teameames/OpenStrain-Bioreactor/README.md

# OpenStrain-Bioreactor
Parts, firmware and assembly details to create an open-source displacement-controlled tensile strain bioreactor for dynamic in vitro cell culture
