teameames/OpenStrain-Bioreactor/OpenStrain Bioreactor Mechanical Unit Solidworks Assembly/Linear Carriage Assembly.SLDASM

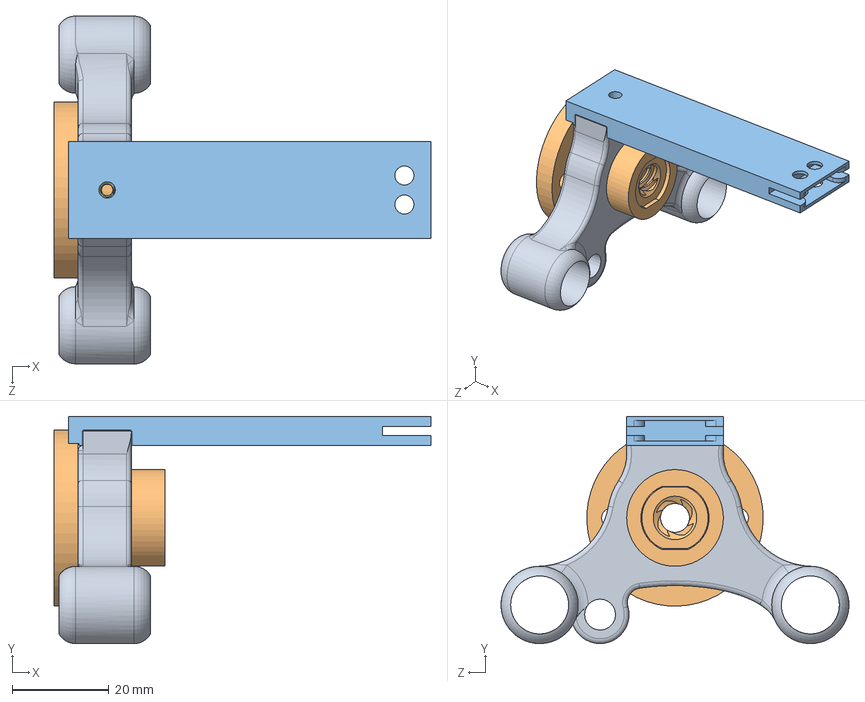
[picture p1: CAD file, 2025-12-15]
OpenStrain Bioreactor Mechanical Unit Solidworks Assembly/Linear Carriage Assembly.SLDASM
78.0 x 47.0 x 72.0 mm
Linear Carriage
Type2 Leadnut
Insert M3 D5 L5mm
