teameames/OpenStrain-Bioreactor/OpenStrain Bioreactor Mechanical Unit Solidworks Assembly/Acrylic well lid assembly.SLDASM

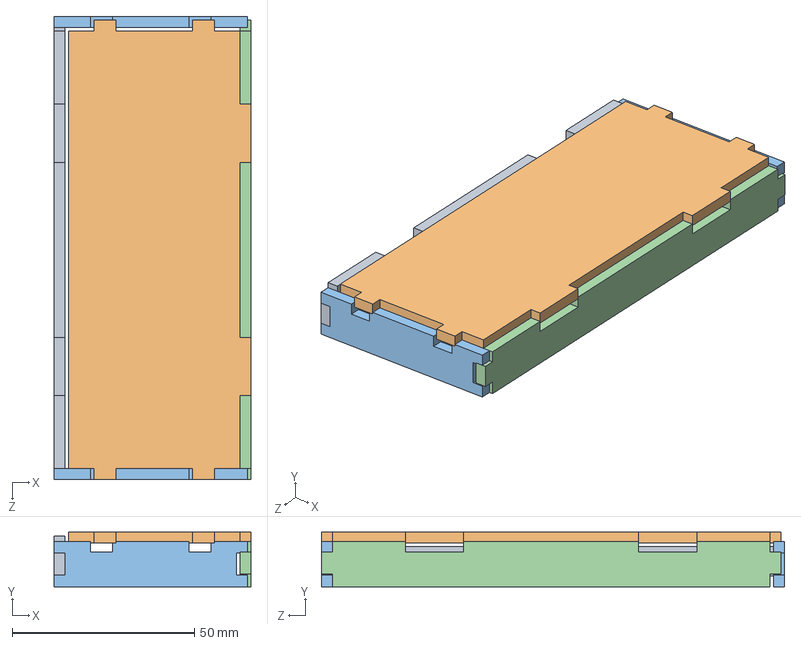
[picture p2: CAD file, 2025-12-15]
OpenStrain Bioreactor Mechanical Unit Solidworks Assembly/Acrylic well lid assembly.SLDASM
54.0 x 15.0 x 127.0 mm
Well Lid Front
Well Lid Side x 2
Well Lid Upper
Well Lid Rear
