teameames/OpenStrain-Bioreactor/OpenStrain Bioreactor Control Unit Solidworks Assembly/Board base.SLDPRT

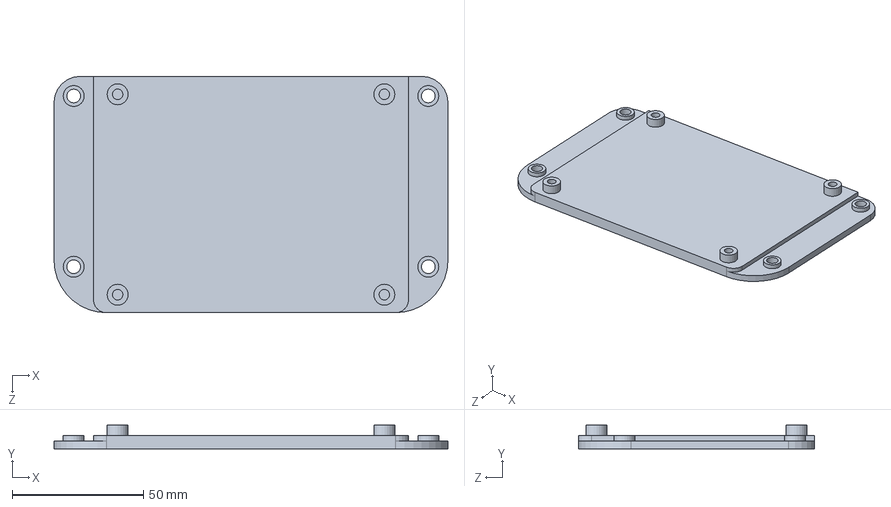
[picture p3: CAD file, 2025-12-15]
OpenStrain Bioreactor Control Unit Solidworks Assembly/Board base.SLDPRT
150.0 x 9.00 x 90.0 mm
