teameames/OpenStrain-Bioreactor/OpenStrain Bioreactor Control Unit STEP files/Adafruit 5.5 x 2.1 DC Coax Panel Mount Power Jack (PN 601)_default.STEP

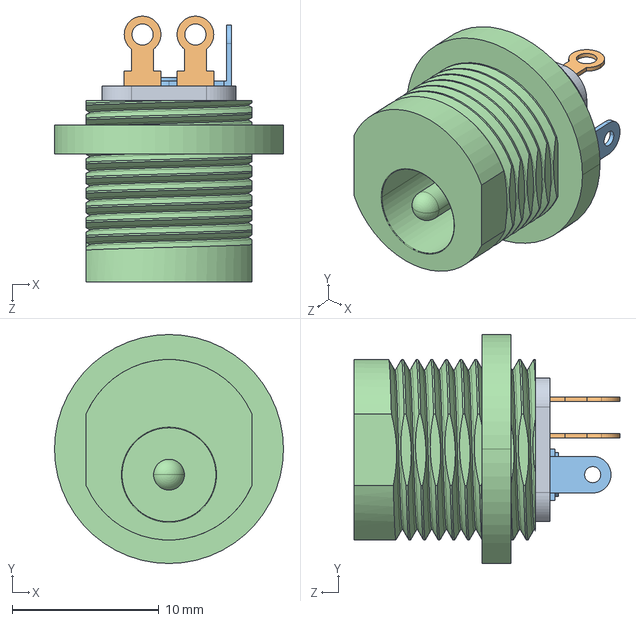
[picture p4: CAD file, 2025-12-15]
OpenStrain Bioreactor Control Unit STEP files/Adafruit 5.5 x 2.1 DC Coax Panel Mount Power Jack (PN 601)_default.STEP
15.6 x 15.6 x 18.1 mm
