teameames/OpenStrain-Bioreactor/OpenStrain Bioreactor Mechanical Unit Solidworks Assembly/Drive Box Base.SLDPRT

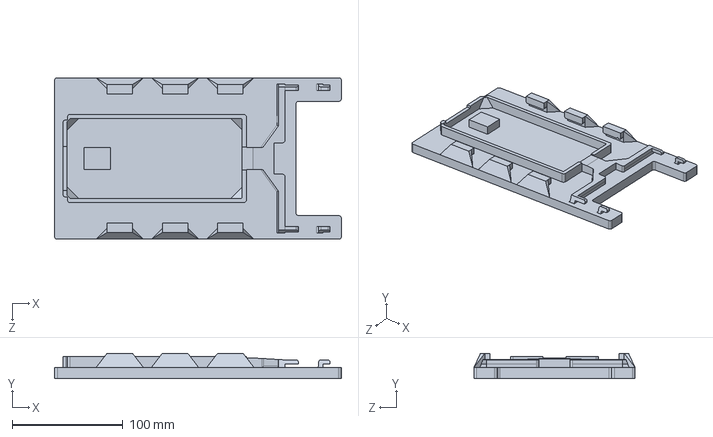
[picture p5: CAD file, 2025-12-15]
OpenStrain Bioreactor Mechanical Unit Solidworks Assembly/Drive Box Base.SLDPRT
259.5 x 23.0 x 146.0 mm
