teameames/OpenStrain-Bioreactor/OpenStrain Bioreactor Control Unit Solidworks Assembly/Case Face.SLDPRT

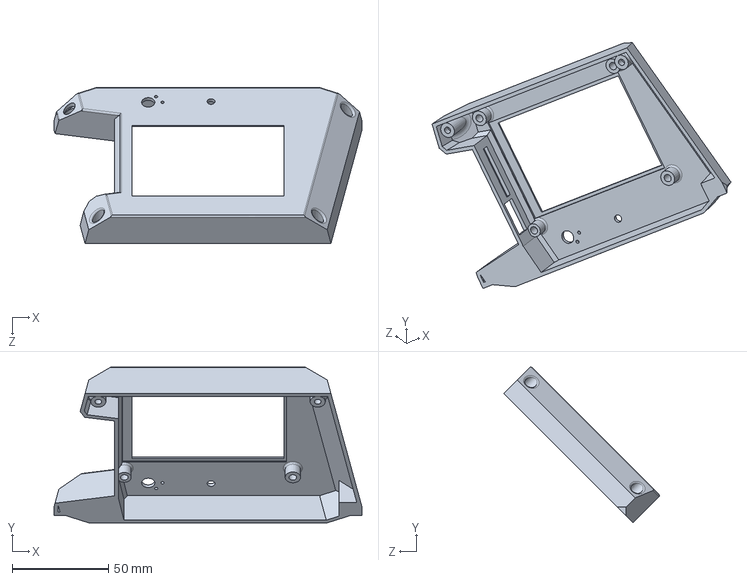
[picture p6: CAD file, 2025-12-15]
OpenStrain Bioreactor Control Unit Solidworks Assembly/Case Face.SLDPRT
160.0 x 80.9 x 80.9 mm
