teameames/OpenStrain-Bioreactor/OpenStrain Bioreactor Control Unit STEP files/30X30X10 DC fan.STEP

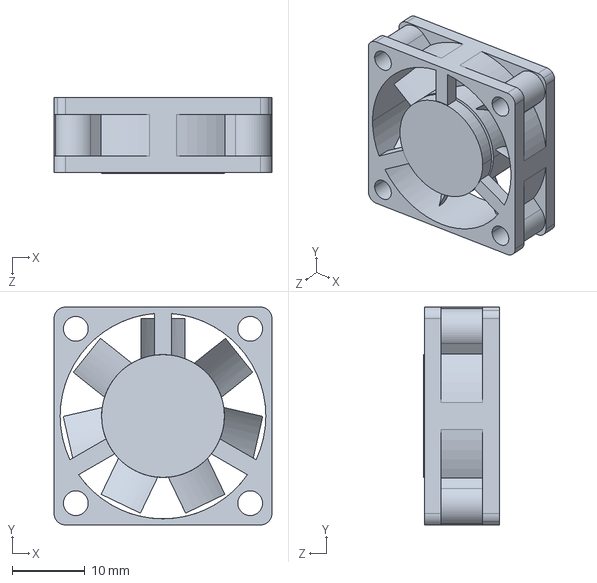
[picture p7: CAD file, 2025-12-15]
OpenStrain Bioreactor Control Unit STEP files/30X30X10 DC fan.STEP
30.0 x 30.0 x 10.4 mm
