teameames/OpenStrain-Bioreactor/OpenStrain Bioreactor Mechanical Unit Solidworks Assembly/Insert M3 D5 L5mm.stp

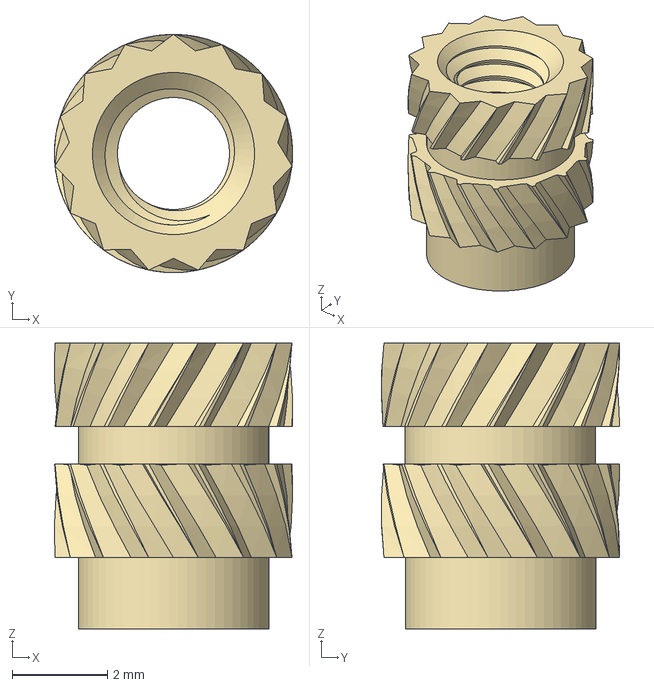
[picture p8: CAD file, 2025-12-15]
OpenStrain Bioreactor Mechanical Unit Solidworks Assembly/Insert M3 D5 L5mm.stp
5.00 x 5.00 x 6.00 mm
