teameames/OpenStrain-Bioreactor/OpenStrain Bioreactor Control Unit Solidworks Assembly/Case Master V2.SLDPRT

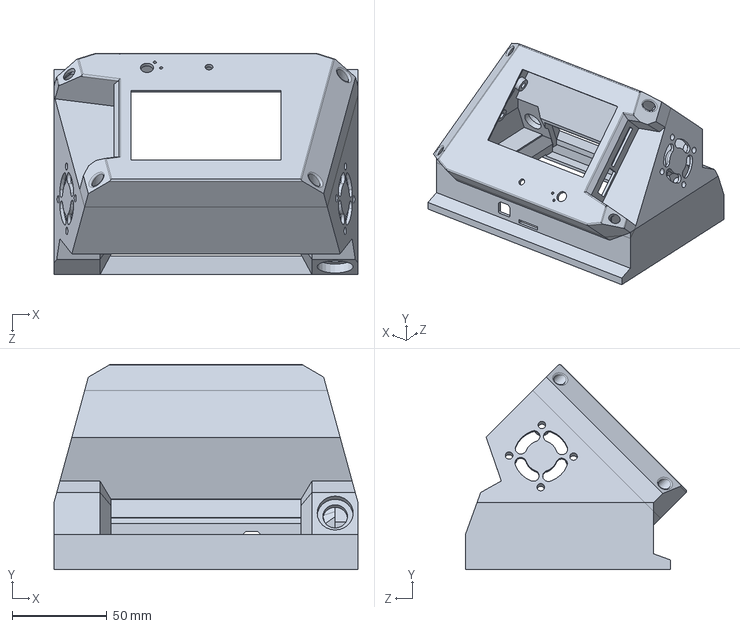
[picture p9: CAD file, 2025-12-15]
OpenStrain Bioreactor Control Unit Solidworks Assembly/Case Master V2.SLDPRT
160.0 x 107.9 x 116.4 mm
