teameames/OpenStrain-Bioreactor/OpenStrain Bioreactor Control Unit STEP files/Insert M5 D7 L9.5mm.STEP

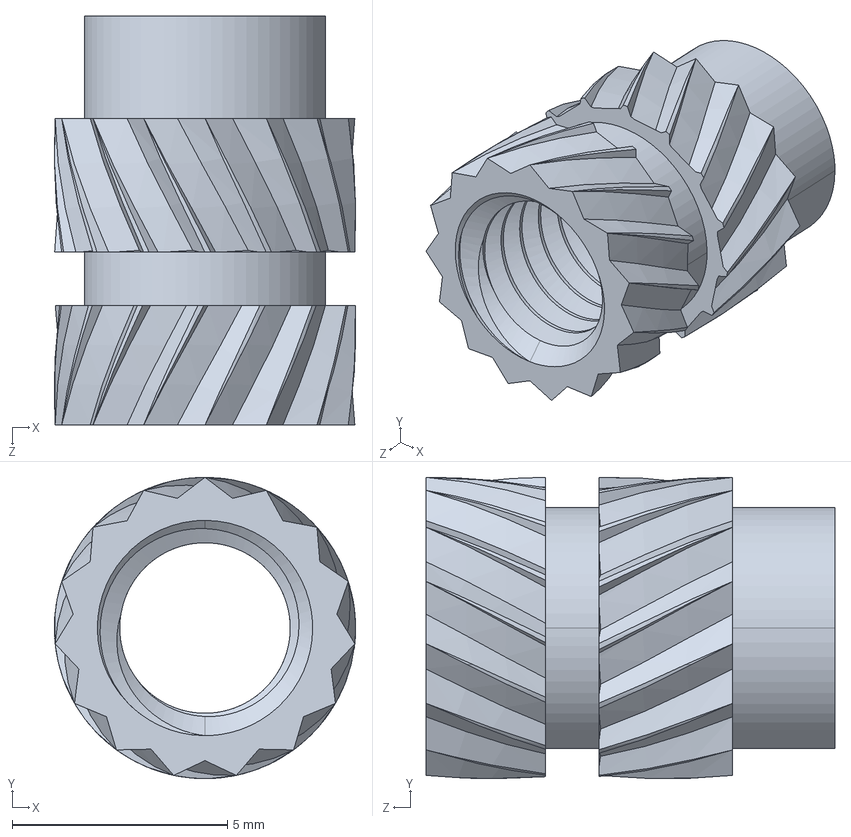
[picture p10: CAD file, 2025-12-15]
OpenStrain Bioreactor Control Unit STEP files/Insert M5 D7 L9.5mm.STEP
7.00 x 7.00 x 9.50 mm
