teameames/OpenStrain-Bioreactor/OpenStrain Bioreactor Mechanical Unit Solidworks Assembly/Well Lid Upper.SLDPRT

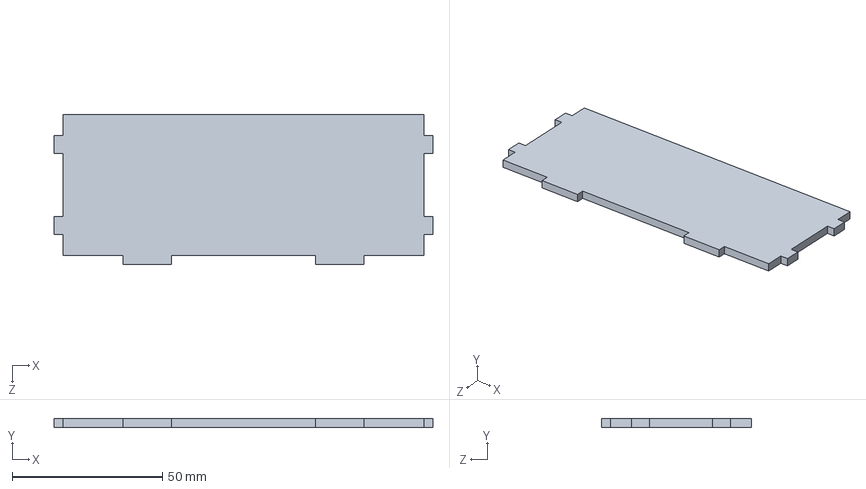
[picture p11: CAD file, 2025-12-15]
OpenStrain Bioreactor Mechanical Unit Solidworks Assembly/Well Lid Upper.SLDPRT
126.0 x 3.00 x 50.0 mm
