teameames/OpenStrain-Bioreactor/OpenStrain Bioreactor Mechanical Unit STEP files/Motor screen window.STEP

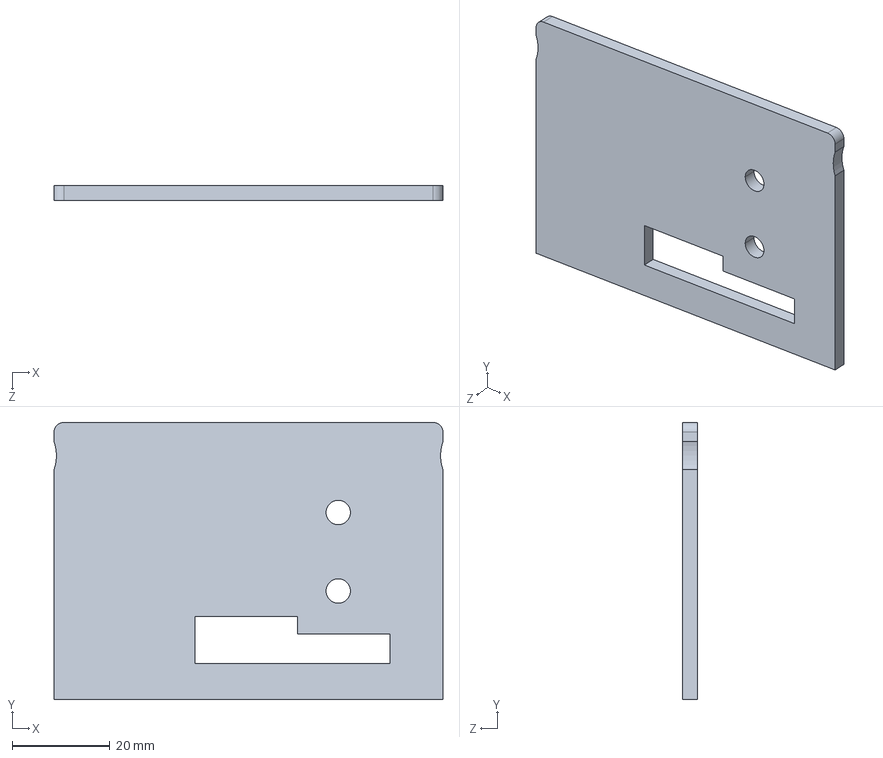
[picture p12: CAD file, 2025-12-15]
OpenStrain Bioreactor Mechanical Unit STEP files/Motor screen window.STEP
79.8 x 56.8 x 3.00 mm
