teameames/OpenStrain-Bioreactor/OpenStrain Bioreactor Control Unit STEP files/Case Face V3.STEP

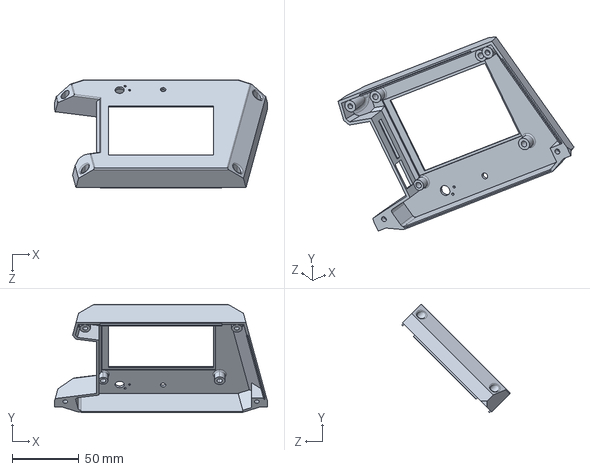
[picture p13: CAD file, 2025-12-15]
OpenStrain Bioreactor Control Unit STEP files/Case Face V3.STEP
160.0 x 81.2 x 81.2 mm
