teameames/OpenStrain-Bioreactor/OpenStrain Bioreactor Mechanical Unit STEP files/8mm Arm Key.STEP

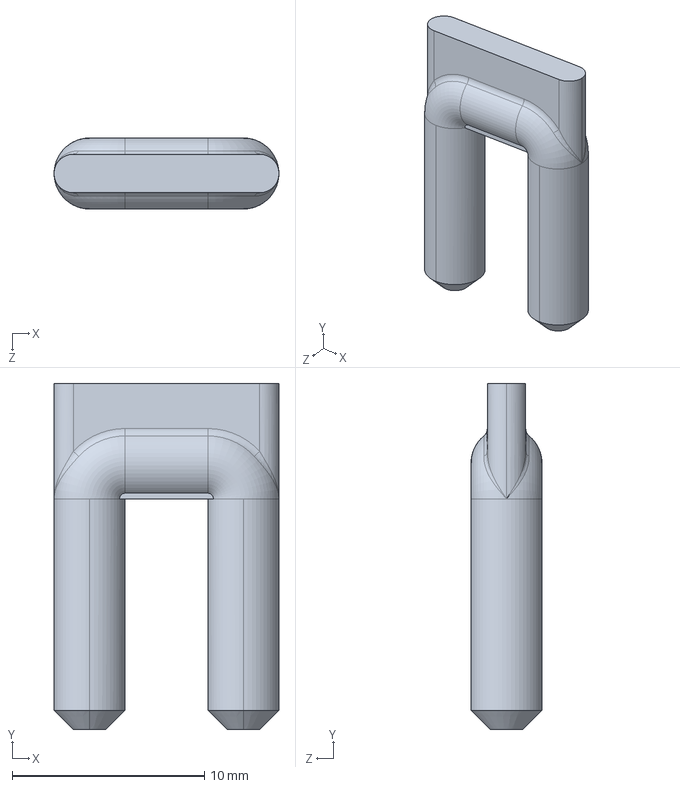
[picture p14: CAD file, 2025-12-15]
OpenStrain Bioreactor Mechanical Unit STEP files/8mm Arm Key.STEP
11.7 x 18.0 x 3.70 mm
