teameames/OpenStrain-Bioreactor/OpenStrain Bioreactor Control Unit Solidworks Assembly/Case Base.SLDPRT

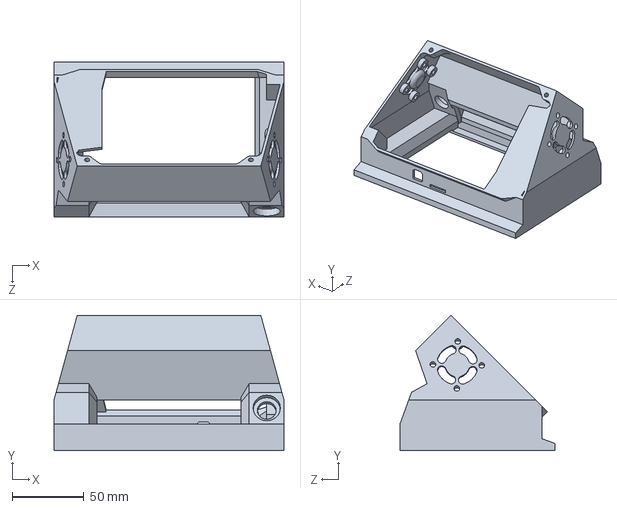
[picture p15: CAD file, 2025-12-15]
OpenStrain Bioreactor Control Unit Solidworks Assembly/Case Base.SLDPRT
160.0 x 94.2 x 108.0 mm
