teameames/OpenStrain-Bioreactor/OpenStrain Bioreactor Mechanical Unit Solidworks Assembly/8mm M5 spring.SLDPRT

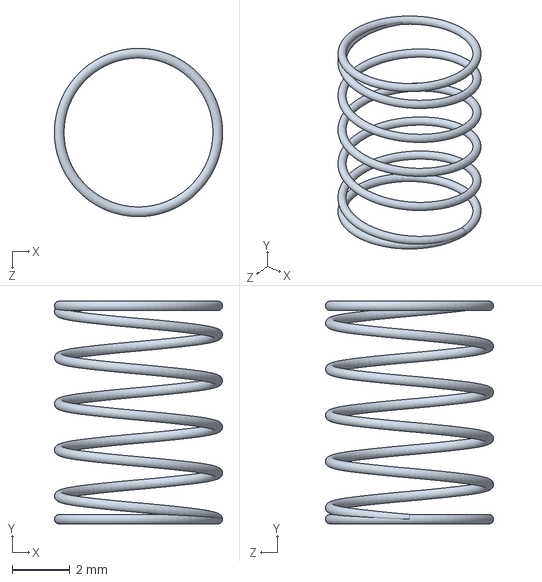
[picture p16: CAD file, 2025-12-15]
OpenStrain Bioreactor Mechanical Unit Solidworks Assembly/8mm M5 spring.SLDPRT
5.84 x 7.74 x 5.84 mm
