teameames/OpenStrain-Bioreactor/OpenStrain Bioreactor Mechanical Unit STEP files/Rack A_Metric - Rack-spur - rectangular 2M 20PA 10FW 10PH 150L---SAll.STEP

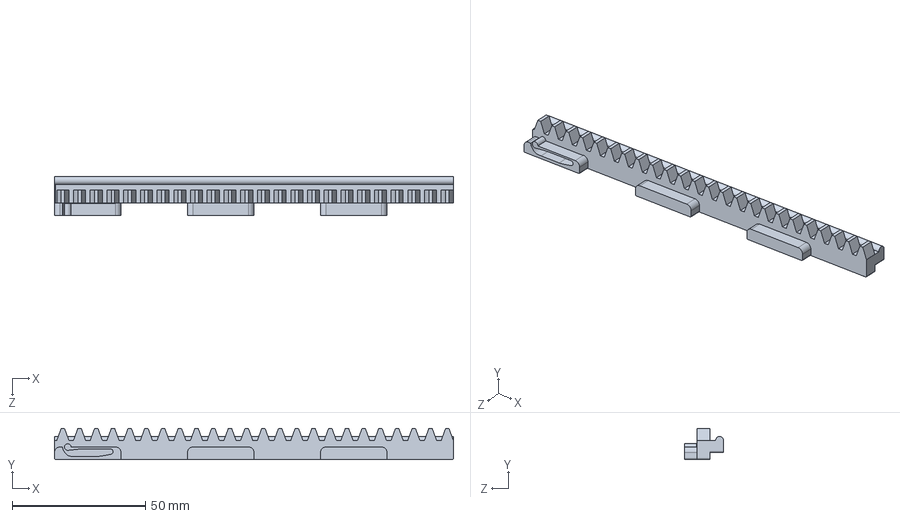
[picture p17: CAD file, 2025-12-15]
OpenStrain Bioreactor Mechanical Unit STEP files/Rack A_Metric - Rack-spur - rectangular 2M 20PA 10FW 10PH 150L---SAll.STEP
150.0 x 11.7 x 14.8 mm
