teameames/OpenStrain-Bioreactor/OpenStrain Bioreactor Mechanical Unit Solidworks Assembly/Well Lid Rear.SLDPRT

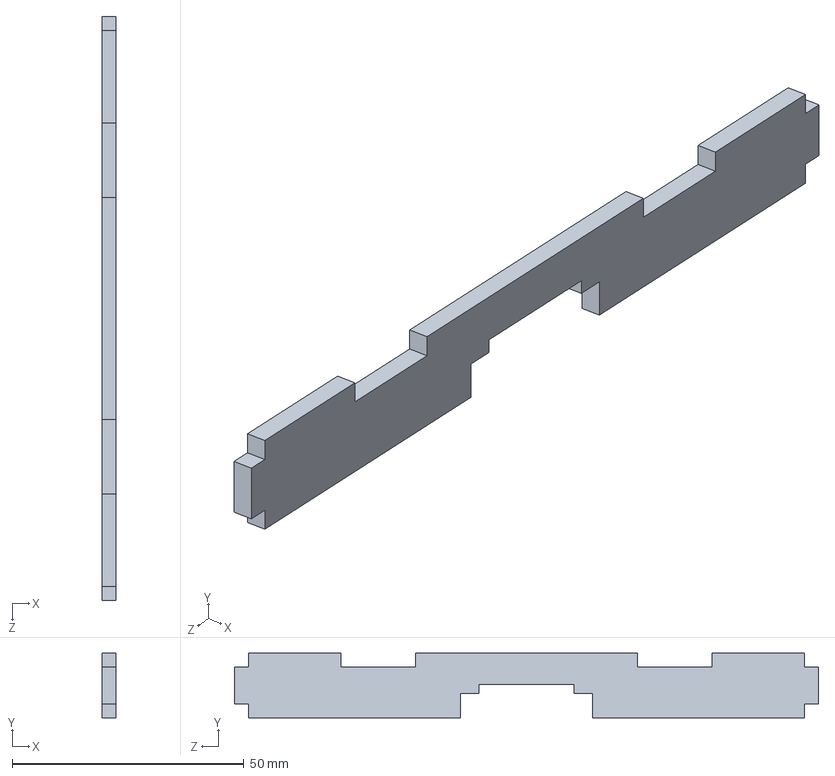
[picture p18: CAD file, 2025-12-15]
OpenStrain Bioreactor Mechanical Unit Solidworks Assembly/Well Lid Rear.SLDPRT
3.00 x 14.0 x 126.0 mm
