teameames/OpenStrain-Bioreactor/OpenStrain Bioreactor Mechanical Unit STEP files/Well Clamp.STEP

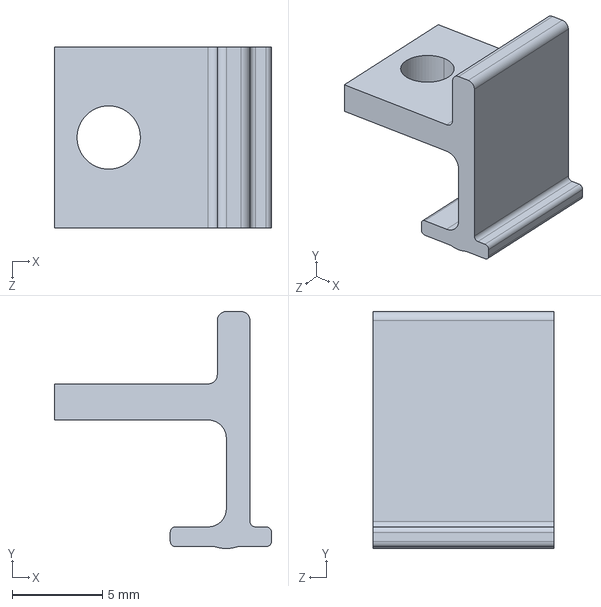
[picture p19: CAD file, 2025-12-15]
OpenStrain Bioreactor Mechanical Unit STEP files/Well Clamp.STEP
12.0 x 13.1 x 10.0 mm
