teameames/OpenStrain-Bioreactor/OpenStrain Bioreactor Control Unit STEP files/Case Base V3.STEP

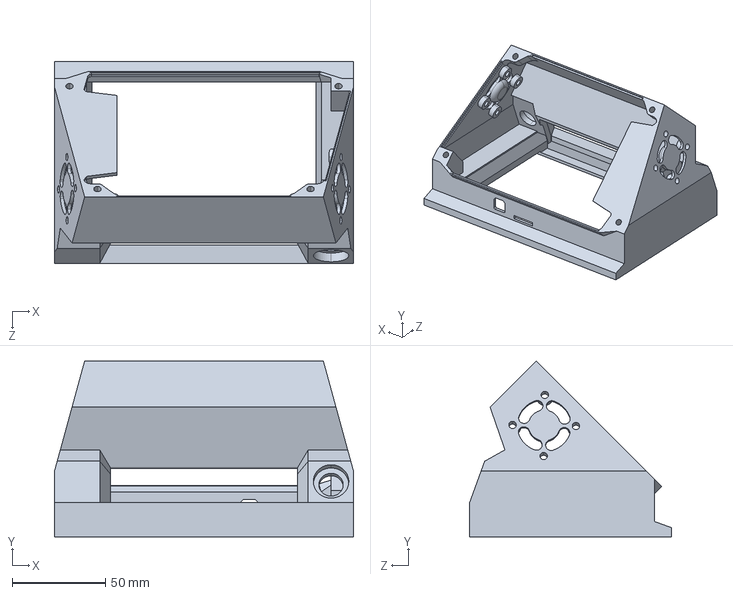
[picture p20: CAD file, 2025-12-15]
OpenStrain Bioreactor Control Unit STEP files/Case Base V3.STEP
160.0 x 94.2 x 108.0 mm
