teameames/OpenStrain-Bioreactor/OpenStrain Bioreactor Mechanical Unit STEP files/Well Lid Side.STEP

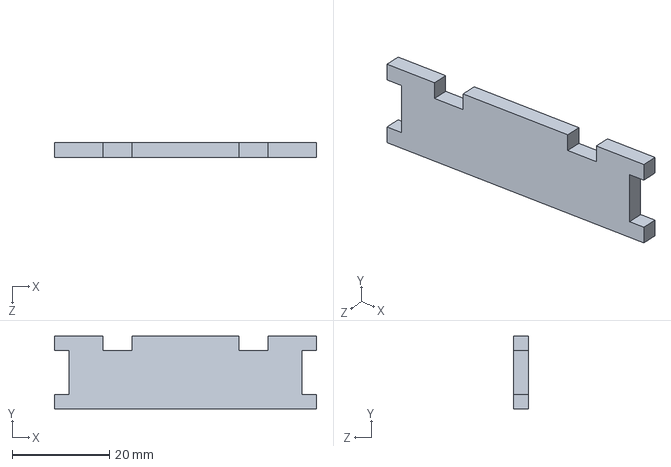
[picture p21: CAD file, 2025-12-15]
OpenStrain Bioreactor Mechanical Unit STEP files/Well Lid Side.STEP
54.0 x 15.0 x 3.00 mm
