teameames/OpenStrain-Bioreactor/OpenStrain Bioreactor Mechanical Unit STEP files/Motor base.STEP

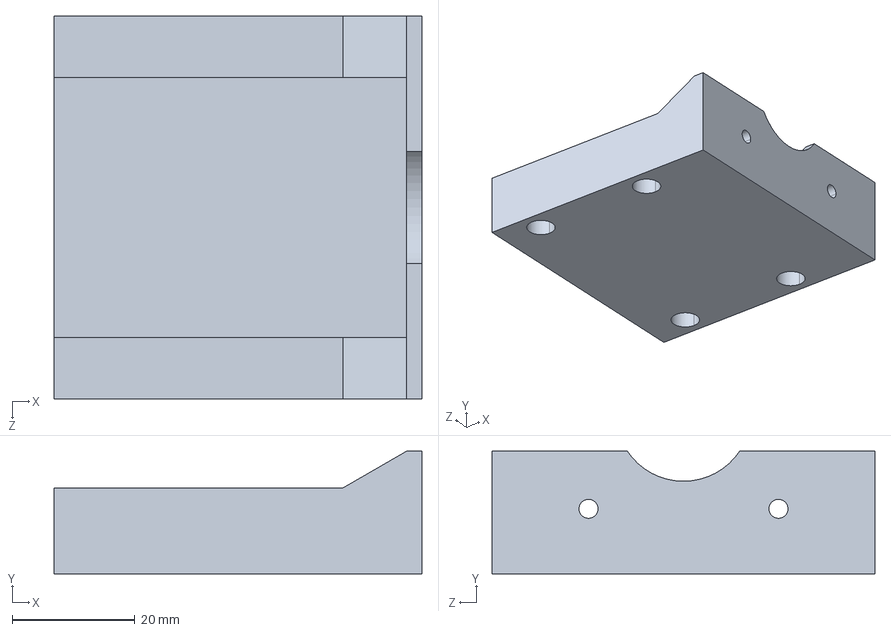
[picture p22: CAD file, 2025-12-15]
OpenStrain Bioreactor Mechanical Unit STEP files/Motor base.STEP
60.0 x 20.0 x 62.5 mm
