teameames/OpenStrain-Bioreactor/OpenStrain Bioreactor Mechanical Unit Solidworks Assembly/Arm Clamp.SLDPRT

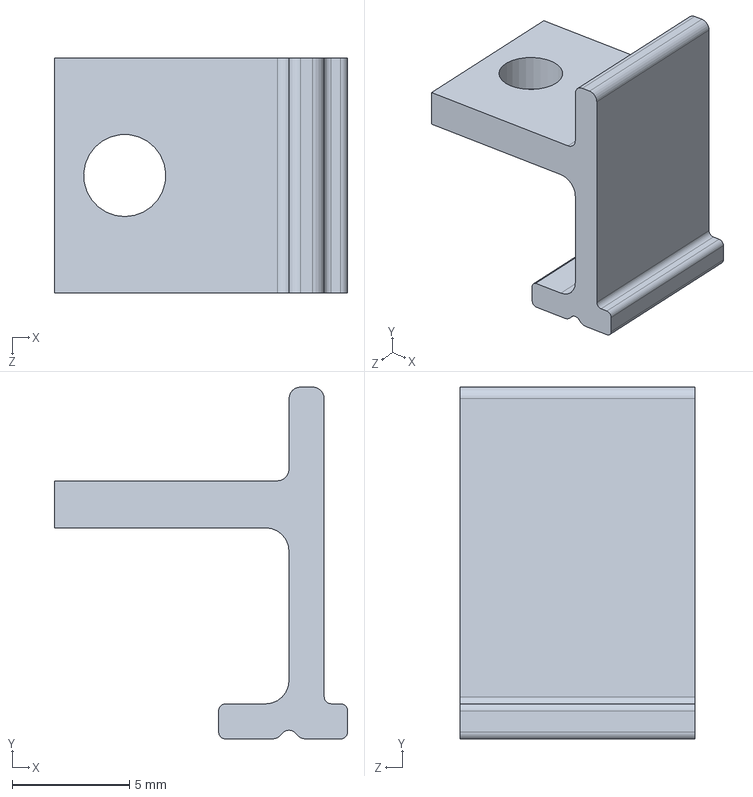
[picture p23: CAD file, 2025-12-15]
OpenStrain Bioreactor Mechanical Unit Solidworks Assembly/Arm Clamp.SLDPRT
12.5 x 15.0 x 10.0 mm
