teameames/OpenStrain-Bioreactor/OpenStrain Bioreactor Mechanical Unit STEP files/Arm Clamp.STEP

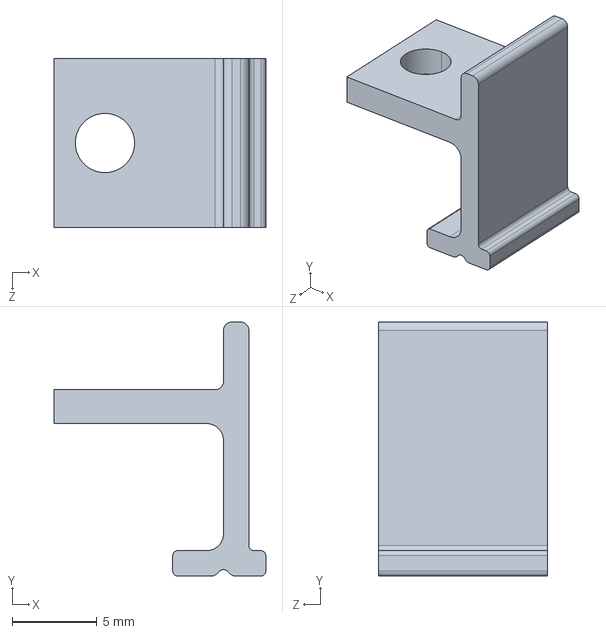
[picture p24: CAD file, 2025-12-15]
OpenStrain Bioreactor Mechanical Unit STEP files/Arm Clamp.STEP
12.5 x 15.0 x 10.0 mm
