teameames/OpenStrain-Bioreactor/OpenStrain Bioreactor Mechanical Unit Solidworks Assembly/G10 Type2 Pull Arm.SLDPRT

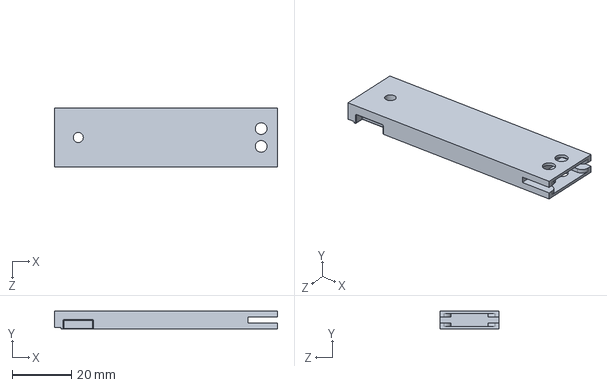
[picture p25: CAD file, 2025-12-15]
OpenStrain Bioreactor Mechanical Unit Solidworks Assembly/G10 Type2 Pull Arm.SLDPRT
75.0 x 6.00 x 20.0 mm
