teameames/OpenStrain-Bioreactor/OpenStrain Bioreactor Mechanical Unit STEP files/Well Lid Front.STEP

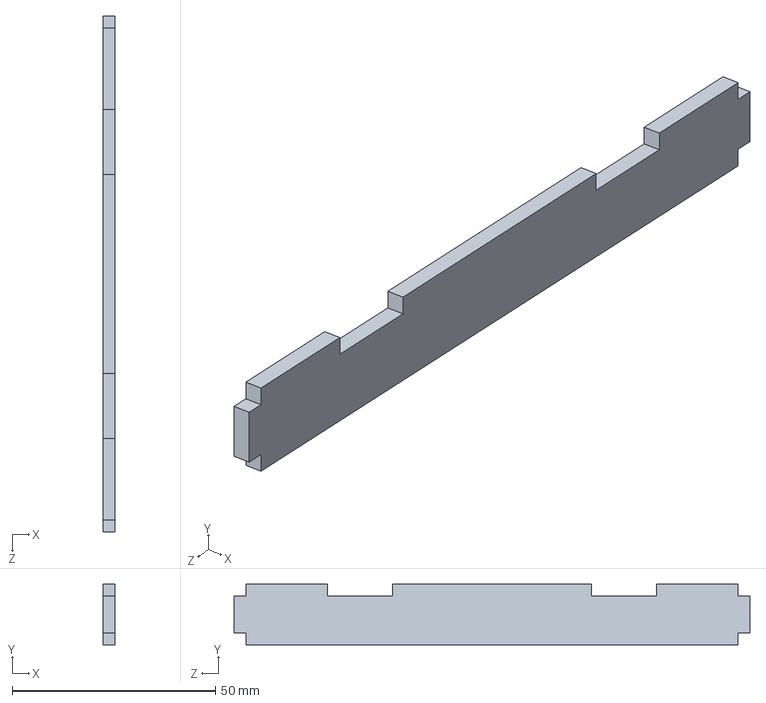
[picture p26: CAD file, 2025-12-15]
OpenStrain Bioreactor Mechanical Unit STEP files/Well Lid Front.STEP
3.00 x 15.0 x 127.0 mm
