teameames/OpenStrain-Bioreactor/OpenStrain Bioreactor Mechanical Unit Solidworks Assembly/Smooth Shaft Clasp A.SLDPRT

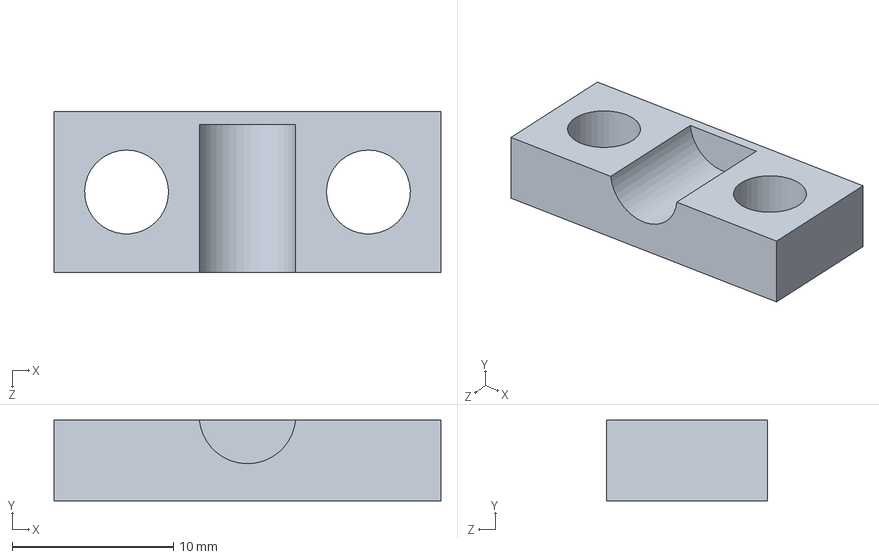
[picture p27: CAD file, 2025-12-15]
OpenStrain Bioreactor Mechanical Unit Solidworks Assembly/Smooth Shaft Clasp A.SLDPRT
24.0 x 5.00 x 10.0 mm
