teameames/OpenStrain-Bioreactor/OpenStrain Bioreactor Mechanical Unit STEP files/MirrorGen10 Smooth Single Clasp.STEP

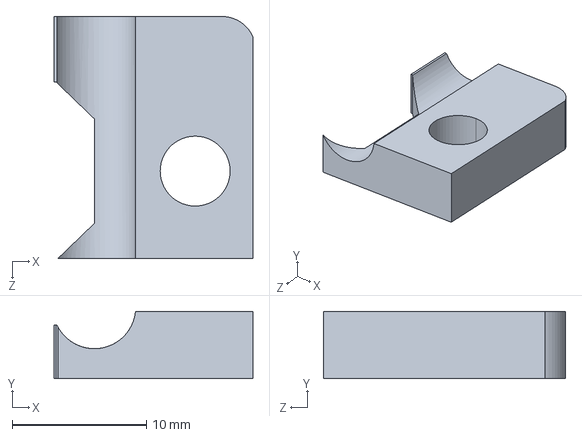
[picture p28: CAD file, 2025-12-15]
OpenStrain Bioreactor Mechanical Unit STEP files/MirrorGen10 Smooth Single Clasp.STEP
14.8 x 5.00 x 18.0 mm
