teameames/OpenStrain-Bioreactor/OpenStrain Bioreactor Mechanical Unit STEP files/spur gear_Metric - Spur gear 2M 16T 20PA 5FW ---S16N75H50L5N.STEP

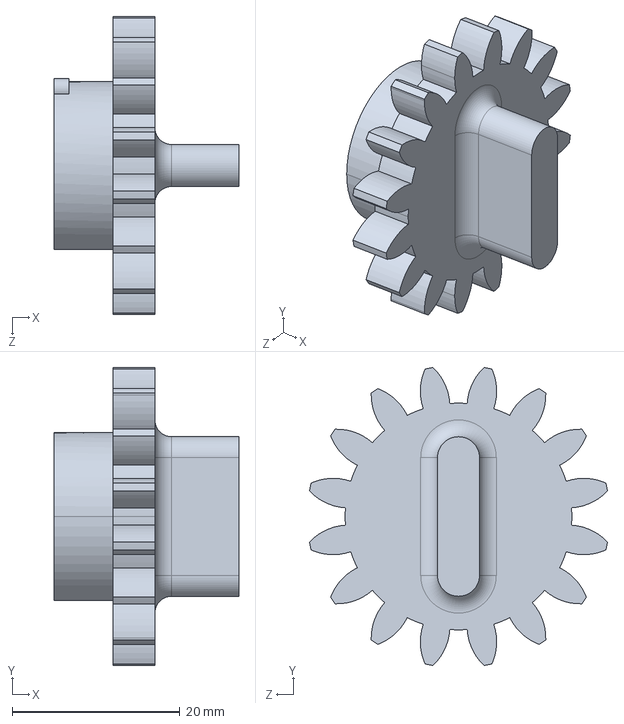
[picture p29: CAD file, 2025-12-15]
OpenStrain Bioreactor Mechanical Unit STEP files/spur gear_Metric - Spur gear 2M 16T 20PA 5FW ---S16N75H50L5N.STEP
22.0 x 35.5 x 35.5 mm
