teameames/OpenStrain-Bioreactor/OpenStrain Bioreactor Mechanical Unit Solidworks Assembly/Shaft coupling.SLDPRT

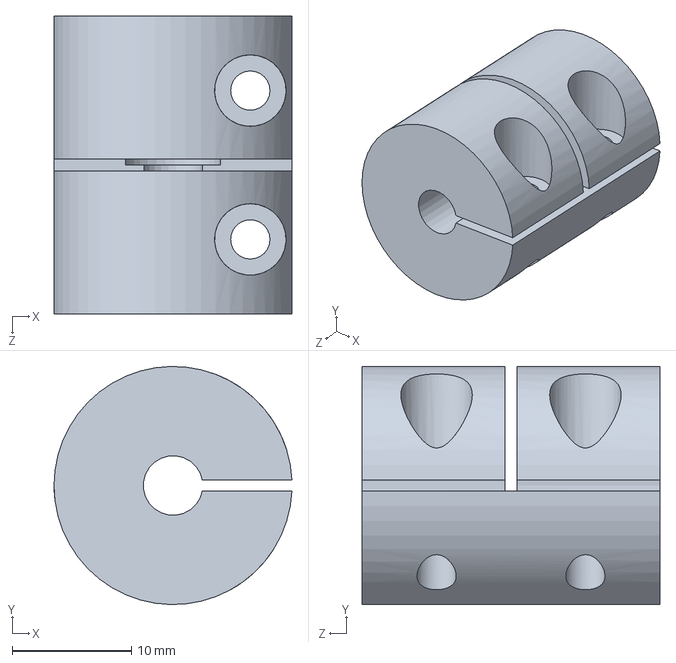
[picture p30: CAD file, 2025-12-15]
OpenStrain Bioreactor Mechanical Unit Solidworks Assembly/Shaft coupling.SLDPRT
20.0 x 20.0 x 25.0 mm
