teameames/OpenStrain-Bioreactor/OpenStrain Bioreactor Mechanical Unit Solidworks Assembly/Well Lid Front.SLDPRT

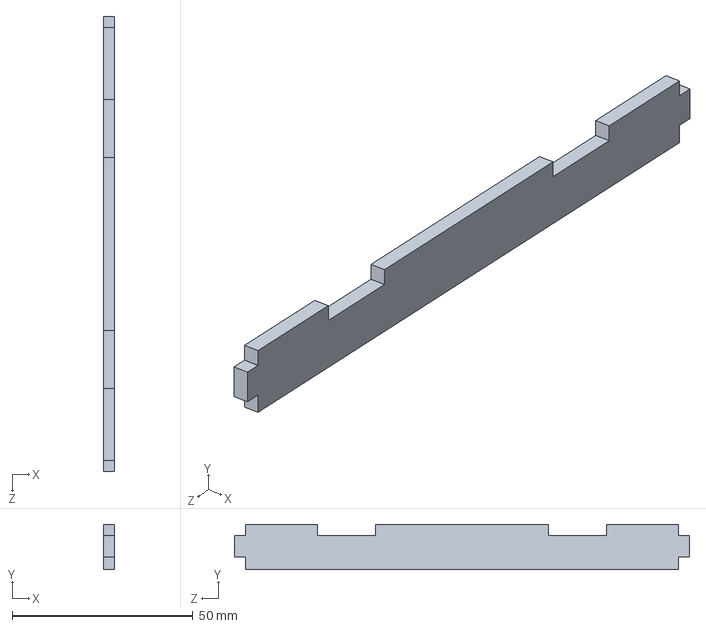
[picture p31: CAD file, 2025-12-15]
OpenStrain Bioreactor Mechanical Unit Solidworks Assembly/Well Lid Front.SLDPRT
3.00 x 12.5 x 126.0 mm
