teameames/OpenStrain-Bioreactor/OpenStrain Bioreactor Mechanical Unit STEP files/Well Lid Upper.STEP

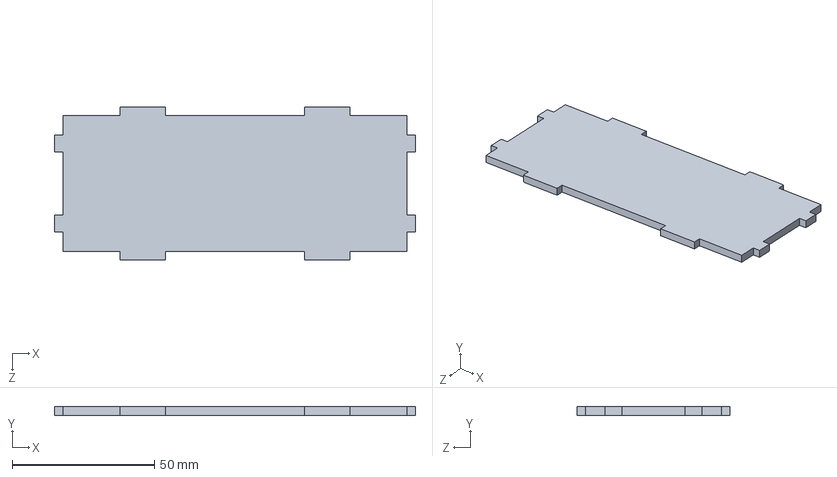
[picture p32: CAD file, 2025-12-15]
OpenStrain Bioreactor Mechanical Unit STEP files/Well Lid Upper.STEP
127.0 x 3.00 x 54.0 mm
