teameames/OpenStrain-Bioreactor/OpenStrain Bioreactor Mechanical Unit Solidworks Assembly/Drive Box.SLDPRT

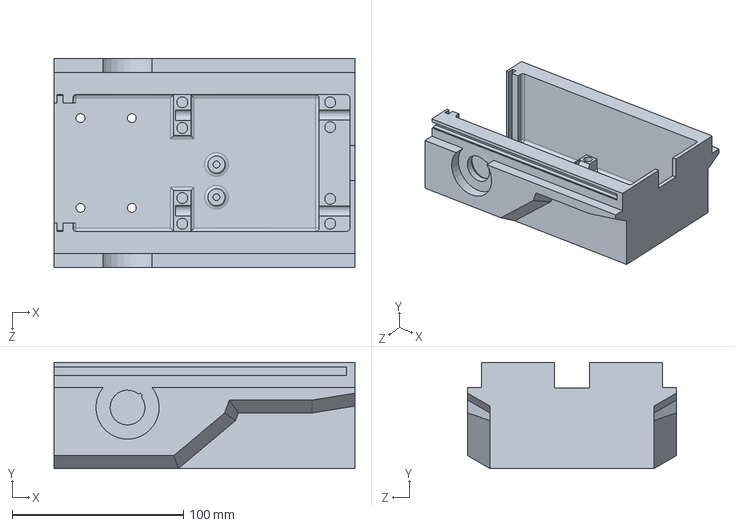
[picture p33: CAD file, 2025-12-15]
OpenStrain Bioreactor Mechanical Unit Solidworks Assembly/Drive Box.SLDPRT
176.0 x 62.0 x 122.0 mm
