teameames/OpenStrain-Bioreactor/OpenStrain Bioreactor Mechanical Unit Solidworks Assembly/Steel Pull Rake.SLDPRT

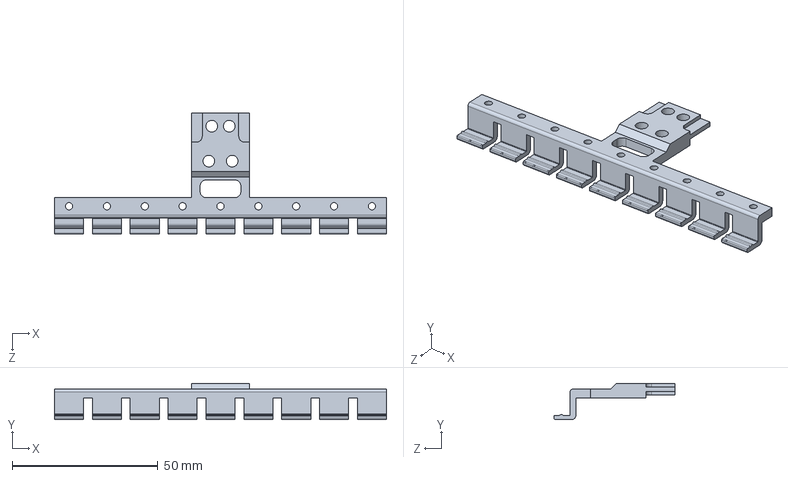
[picture p34: CAD file, 2025-12-15]
OpenStrain Bioreactor Mechanical Unit Solidworks Assembly/Steel Pull Rake.SLDPRT
114.0 x 12.5 x 41.5 mm
