teameames/OpenStrain-Bioreactor/OpenStrain Bioreactor Mechanical Unit Solidworks Assembly/Limit_switch.SLDPRT

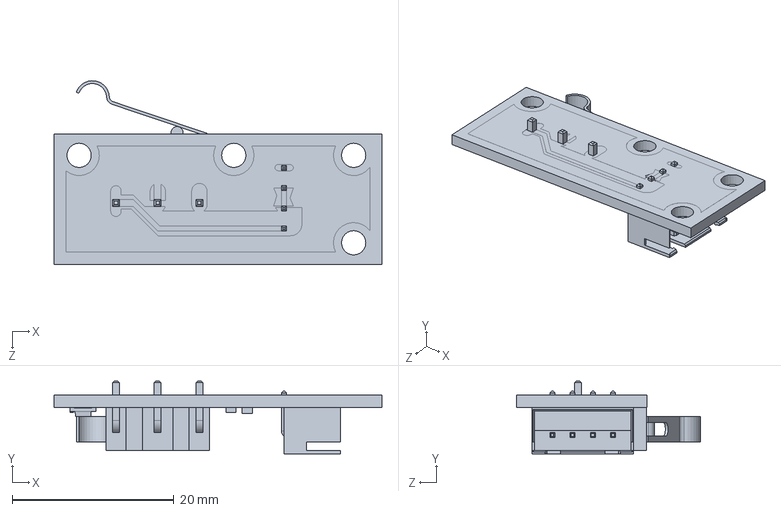
[picture p35: CAD file, 2025-12-15]
OpenStrain Bioreactor Mechanical Unit Solidworks Assembly/Limit_switch.SLDPRT
40.5 x 9.00 x 22.7 mm
