teameames/OpenStrain-Bioreactor/OpenStrain Bioreactor Mechanical Unit Solidworks Assembly/Well Lid Side.SLDPRT

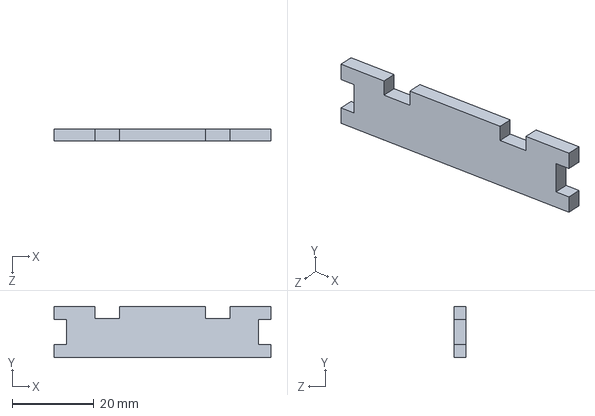
[picture p36: CAD file, 2025-12-15]
OpenStrain Bioreactor Mechanical Unit Solidworks Assembly/Well Lid Side.SLDPRT
53.0 x 12.5 x 3.00 mm
