teameames/OpenStrain-Bioreactor/OpenStrain Bioreactor Mechanical Unit Solidworks Assembly/Pillow Block P08.SLDPRT

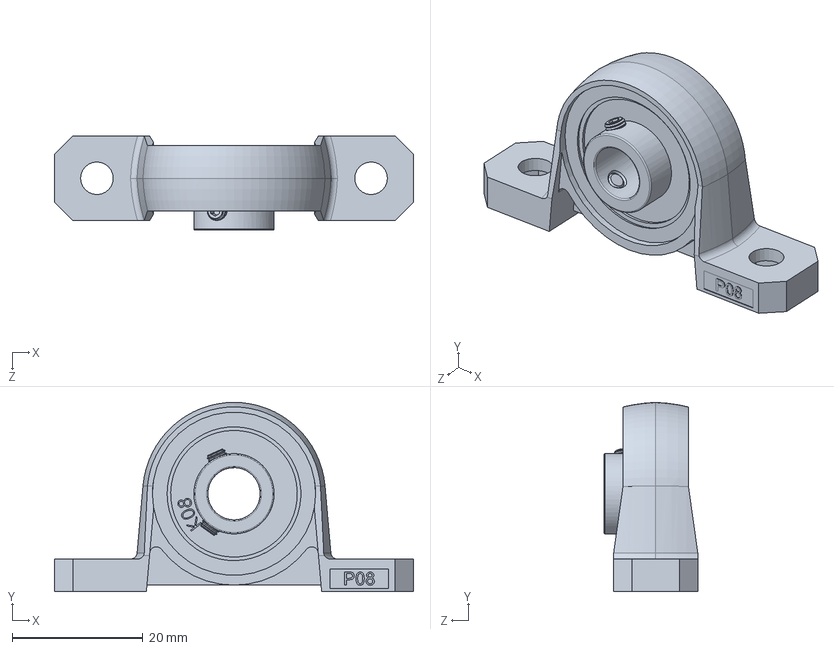
[picture p37: CAD file, 2025-12-15]
OpenStrain Bioreactor Mechanical Unit Solidworks Assembly/Pillow Block P08.SLDPRT
55.0 x 29.0 x 14.5 mm
