teameames/OpenStrain-Bioreactor/OpenStrain Bioreactor Mechanical Unit STEP files/Limit_switch.STEP

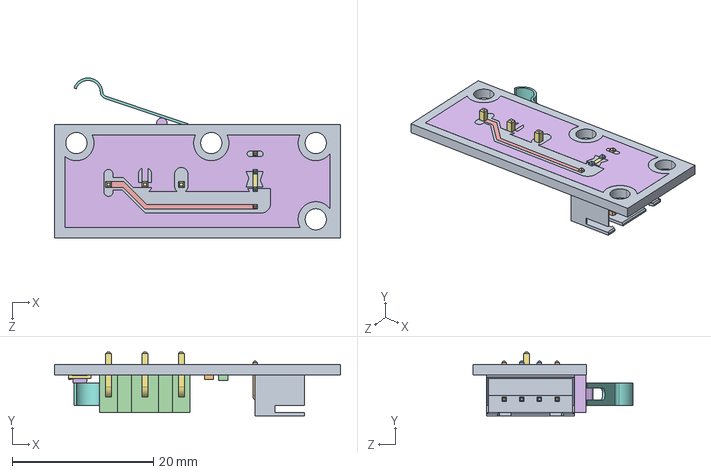
[picture p39: CAD file, 2025-12-15]
OpenStrain Bioreactor Mechanical Unit STEP files/Limit_switch.STEP
40.5 x 9.00 x 22.7 mm
