teameames/OpenStrain-Bioreactor/OpenStrain Bioreactor Mechanical Unit Solidworks Assembly/BTT S42C Closer Loop Stepper Motor.SLDPRT

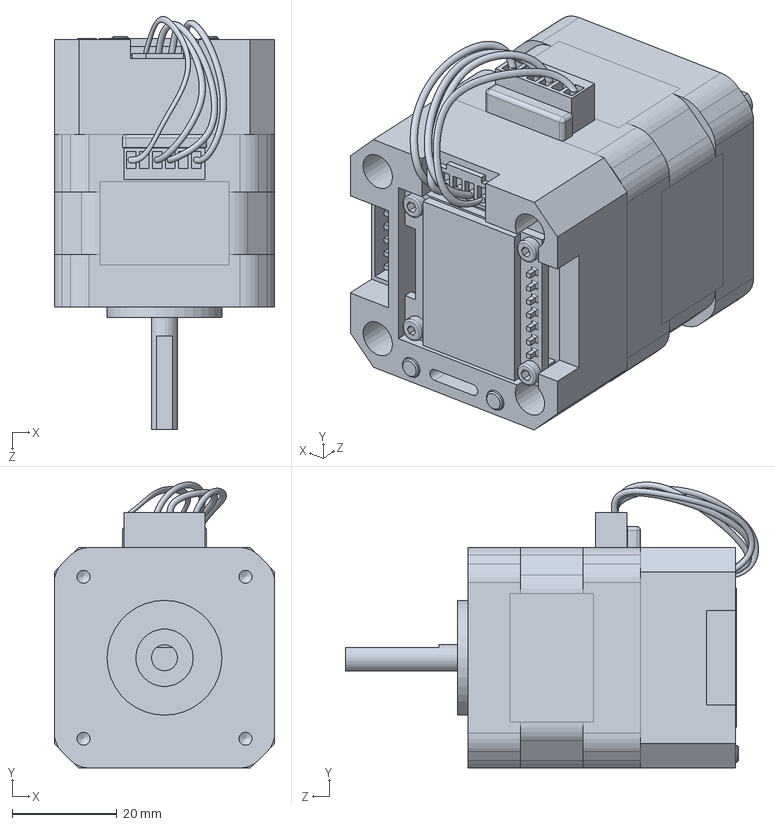
[picture p40: CAD file, 2025-12-15]
OpenStrain Bioreactor Mechanical Unit Solidworks Assembly/BTT S42C Closer Loop Stepper Motor.SLDPRT
42.2 x 54.7 x 79.1 mm
