teameames/OpenStrain-Bioreactor/OpenStrain Bioreactor Mechanical Unit STEP files/OpenStrain Steel Well.STEP

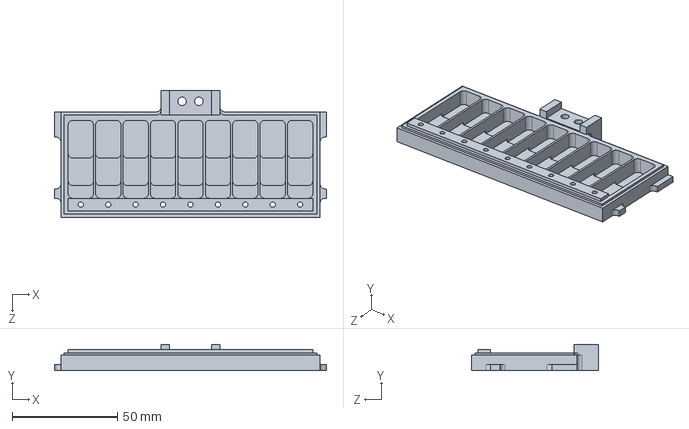
[picture p41: CAD file, 2025-12-15]
OpenStrain Bioreactor Mechanical Unit STEP files/OpenStrain Steel Well.STEP
129.0 x 12.5 x 60.0 mm
