teameames/OpenStrain-Bioreactor/OpenStrain Bioreactor Mechanical Unit Solidworks Assembly/Motor base.SLDPRT

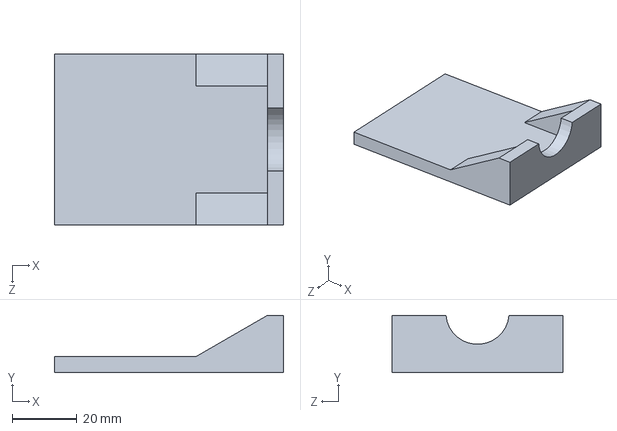
[picture p42: CAD file, 2025-12-15]
OpenStrain Bioreactor Mechanical Unit Solidworks Assembly/Motor base.SLDPRT
70.9 x 17.7 x 53.0 mm
