teameames/OpenStrain-Bioreactor/OpenStrain Bioreactor Mechanical Unit STEP files/Linear Carriage.STEP

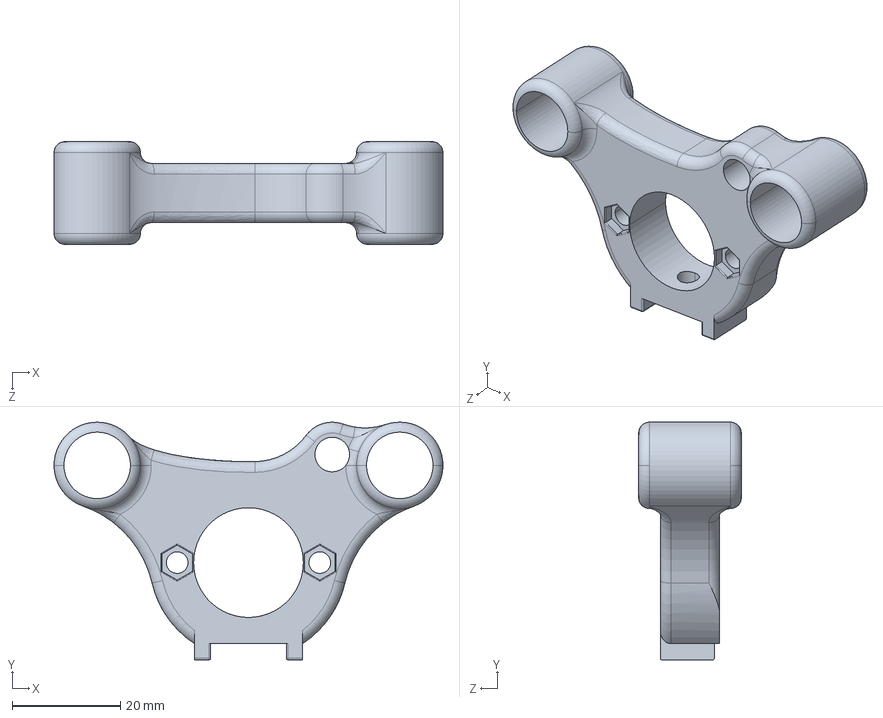
[picture p43: CAD file, 2025-12-15]
OpenStrain Bioreactor Mechanical Unit STEP files/Linear Carriage.STEP
72.0 x 44.0 x 19.0 mm
