teameames/OpenStrain-Bioreactor/OpenStrain Bioreactor Mechanical Unit Solidworks Assembly/OpenStrain Steel Well.SLDPRT

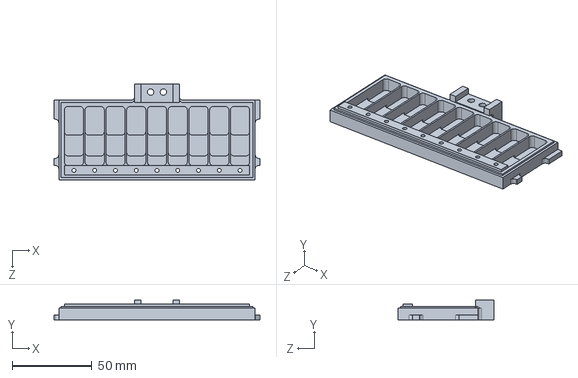
[picture p44: CAD file, 2025-12-15]
OpenStrain Bioreactor Mechanical Unit Solidworks Assembly/OpenStrain Steel Well.SLDPRT
129.0 x 12.5 x 60.0 mm
