teameames/OpenStrain-Bioreactor/OpenStrain Bioreactor Mechanical Unit Solidworks Assembly/Linear bearing 6mm.SLDPRT

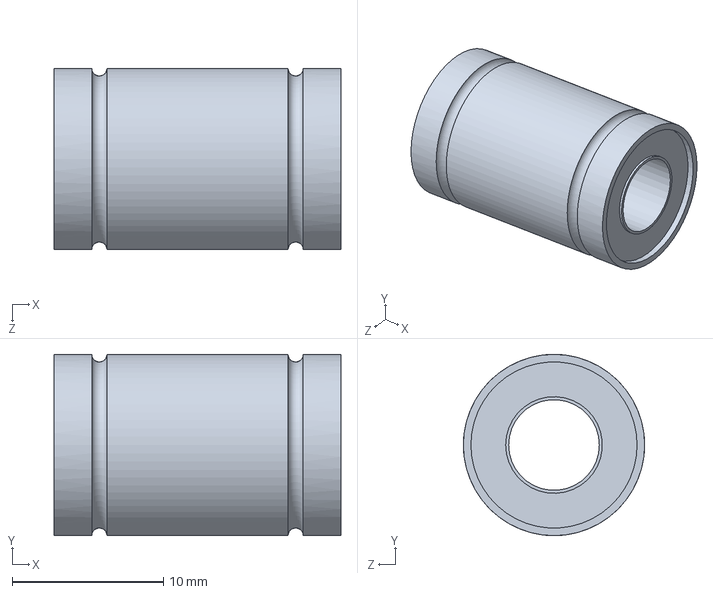
[picture p45: CAD file, 2025-12-15]
OpenStrain Bioreactor Mechanical Unit Solidworks Assembly/Linear bearing 6mm.SLDPRT
19.0 x 12.0 x 12.0 mm
