teameames/OpenStrain-Bioreactor/OpenStrain Bioreactor Mechanical Unit STEP files/Smooth Shaft 6mm.STEP

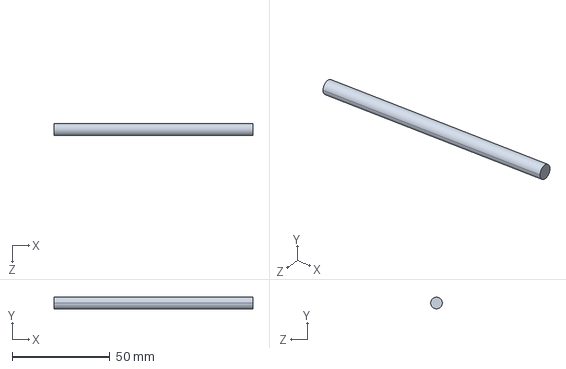
[picture p46: CAD file, 2025-12-15]
OpenStrain Bioreactor Mechanical Unit STEP files/Smooth Shaft 6mm.STEP
102.0 x 6.00 x 6.00 mm
