teameames/OpenStrain-Bioreactor/OpenStrain Bioreactor Mechanical Unit Solidworks Assembly/spur gear.SLDPRT

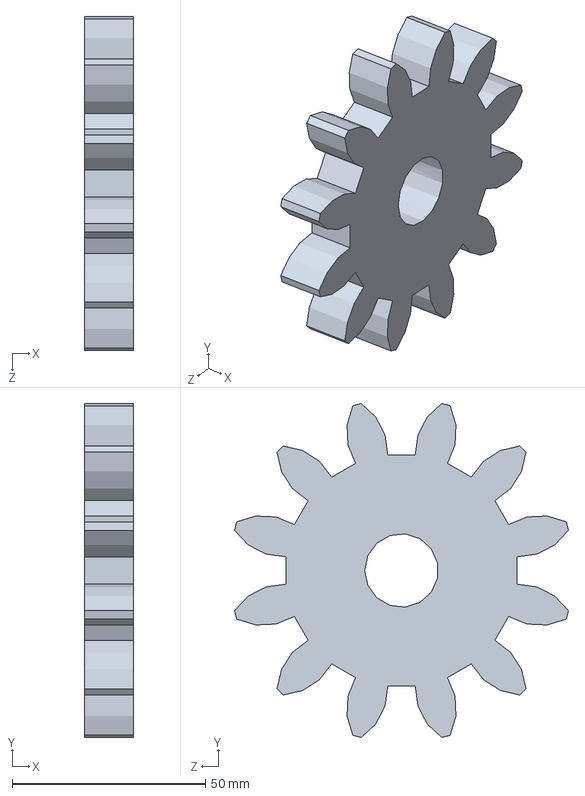
[picture p47: CAD file, 2025-12-15]
OpenStrain Bioreactor Mechanical Unit Solidworks Assembly/spur gear.SLDPRT
12.7 x 86.4 x 86.4 mm
