teameames/OpenStrain-Bioreactor/OpenStrain Bioreactor Mechanical Unit Solidworks Assembly/Linear Carriage.SLDPRT

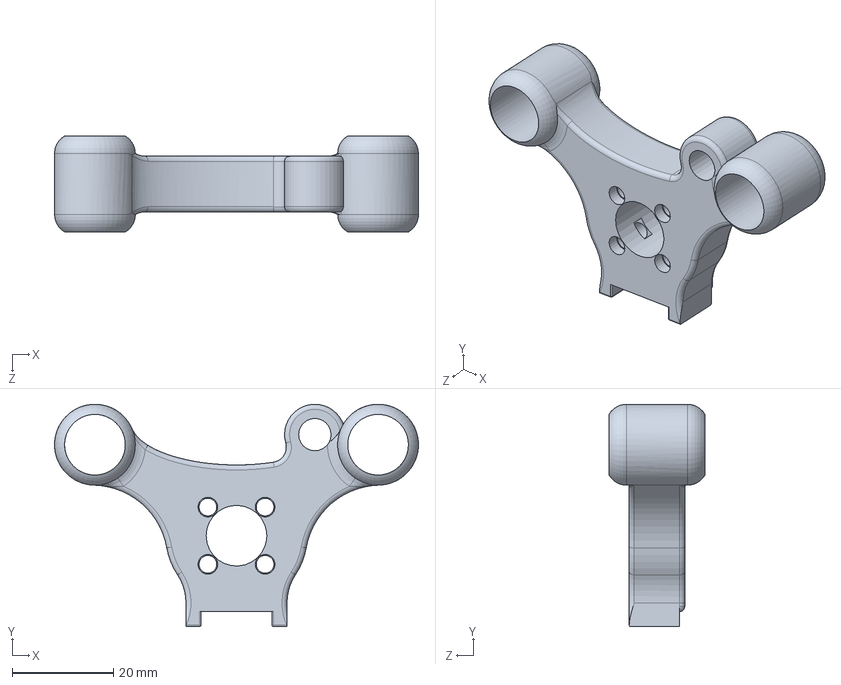
[picture p48: CAD file, 2025-12-15]
OpenStrain Bioreactor Mechanical Unit Solidworks Assembly/Linear Carriage.SLDPRT
72.0 x 44.0 x 19.0 mm
