teameames/OpenStrain-Bioreactor/OpenStrain Bioreactor Mechanical Unit Solidworks Assembly/6mm Well Key.SLDPRT

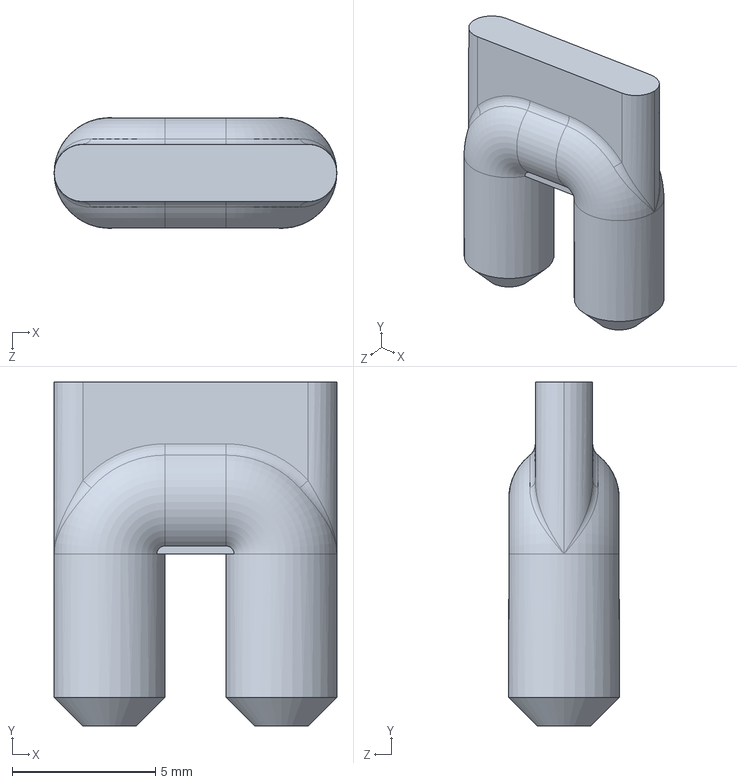
[picture p49: CAD file, 2025-12-15]
OpenStrain Bioreactor Mechanical Unit Solidworks Assembly/6mm Well Key.SLDPRT
9.86 x 12.0 x 3.86 mm
