teameames/OpenStrain-Bioreactor/OpenStrain Bioreactor Control Unit Solidworks Assembly/True Coaxial DC Panel Mount Power Jack (PN 610).SLDASM

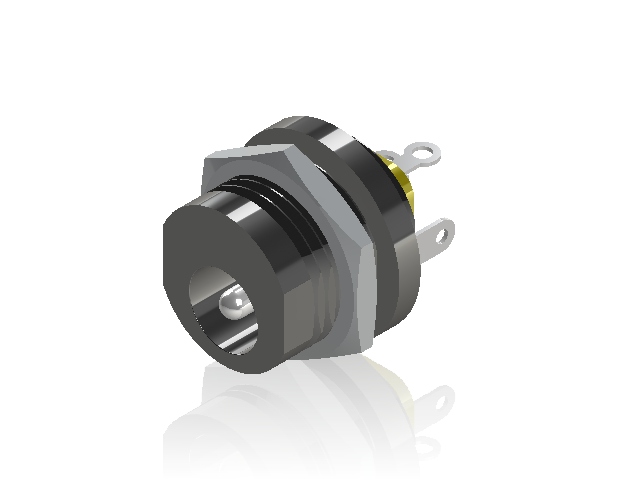
[picture p50: CAD file, 2025-12-15]
OpenStrain Bioreactor Control Unit Solidworks Assembly/True Coaxial DC Panel Mount Power Jack (PN 610).SLDASM
Adafruit 5.5 x 2.1 DC Coax Panel Mount Power Jack (PN 601)_default
M12.5x1 Panel Nut_default
