teameames/OpenStrain-Bioreactor/OpenStrain Bioreactor Mechanical Unit Solidworks Assembly/OpenStrain Well Assembly.SLDASM

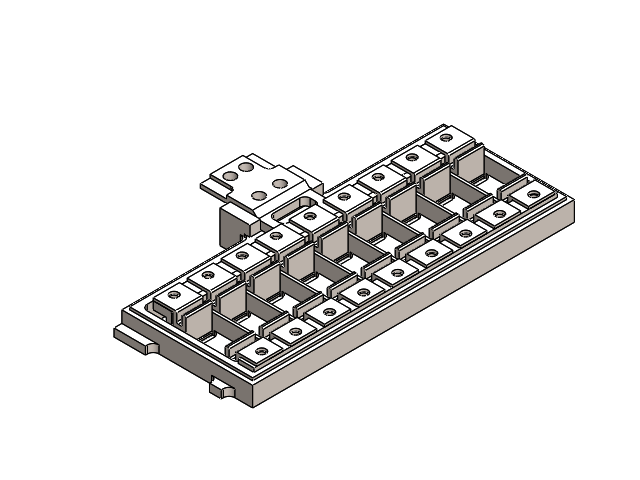
[picture p51: CAD file, 2025-12-15]
OpenStrain Bioreactor Mechanical Unit Solidworks Assembly/OpenStrain Well Assembly.SLDASM
OpenStrain Steel Well
Steel Pull Rake
Arm Clamp x 9
Well Clamp x 9
hexagon socket head cap screw_as x 18
