teameames/OpenStrain-Bioreactor/(list of files, cad)

Other CAD files:
OpenStrain Bioreactor Mechanical Unit STEP files/Linear Carriage Assembly.STEP
OpenStrain Bioreactor Mechanical Unit STEP files/Acrylic well lid assembly.STEP
OpenStrain Bioreactor Mechanical Unit STEP files/OpenStrain Well Assembly.STEP
OpenStrain Bioreactor Mechanical Unit STEP files/Drive Box Base.STEP
OpenStrain Bioreactor Control Unit Solidworks Assembly/Case Face V3.SLDPRT
OpenStrain Bioreactor Control Unit STEP files/Board base.STEP
OpenStrain Bioreactor Mechanical Unit Solidworks Assembly/Rack B.SLDPRT
OpenStrain Bioreactor Control Unit STEP files/True Coaxial DC Panel Mount Power Jack (PN 610).STEP
OpenStrain Bioreactor Control Unit STEP files/OpenStrain Control Unit.STEP
OpenStrain Bioreactor Control Unit Solidworks Assembly/Adafruit 5.5 x 2.1 DC Coax Panel Mount Power Jack (PN 601)_default.SLDPRT
OpenStrain Bioreactor Control Unit Solidworks Assembly/Case Base V3.SLDPRT
OpenStrain Bioreactor Mechanical Unit Solidworks Assembly/Well Clamp.SLDPRT
OpenStrain Bioreactor Control Unit Solidworks Assembly/30X30X10 DC fan.SLDPRT
OpenStrain Bioreactor Control Unit STEP files/Insert M3 D5 L5mm.STEP
OpenStrain Bioreactor Mechanical Unit STEP files/Rack B_Metric - Rack-spur - rectangular 2M 20PA 10FW 10PH 150L---SAll.STEP
OpenStrain Bioreactor Control Unit Solidworks Assembly/Insert M5 D7 L9.5mm.SLDPRT
OpenStrain Bioreactor Mechanical Unit Solidworks Assembly/MirrorGen10 Smooth Single Clasp.SLDPRT
OpenStrain Bioreactor Control Unit Solidworks Assembly/Insert M3 D5 L5mm.SLDPRT
OpenStrain Bioreactor Mechanical Unit Solidworks Assembly/8mm Arm Key.SLDPRT
OpenStrain Bioreactor Mechanical Unit STEP files/8mm M5 spring.STEP
OpenStrain Bioreactor Mechanical Unit STEP files/Insert M3 D5 L5mm.STEP
OpenStrain Bioreactor Mechanical Unit STEP files/OpenStrain Mechanical Unit.STEP
OpenStrain Bioreactor Mechanical Unit Solidworks Assembly/Insert M5 D7 L9.5mm.stp
OpenStrain Bioreactor Mechanical Unit STEP files/Drive Box.STEP
OpenStrain Bioreactor Mechanical Unit STEP files/G10 Type2 Pull Arm.STEP
OpenStrain Bioreactor Mechanical Unit Solidworks Assembly/Smooth Shaft 6mm.SLDPRT
OpenStrain Bioreactor Mechanical Unit STEP files/Insert M5 D7 L9.5mm.STEP
OpenStrain Bioreactor Mechanical Unit STEP files/Smooth Shaft Clasp C.STEP
OpenStrain Bioreactor Mechanical Unit Solidworks Assembly/Pull Arm.SLDPRT
OpenStrain Bioreactor Mechanical Unit Solidworks Assembly/Smooth Shaft Clasp C.SLDPRT
OpenStrain Bioreactor Mechanical Unit STEP files/Steel Pull Rake.STEP
OpenStrain Bioreactor Mechanical Unit STEP files/Pillow Block P08.STEP
OpenStrain Bioreactor Mechanical Unit Solidworks Assembly/Rack A.SLDPRT
OpenStrain Bioreactor Mechanical Unit Solidworks Assembly/Mirrorspur gear.SLDPRT
OpenStrain Bioreactor Mechanical Unit STEP files/Shaft coupling.STEP
OpenStrain Bioreactor Mechanical Unit STEP files/Smooth Shaft Clasp A.STEP
OpenStrain Bioreactor Mechanical Unit STEP files/6mm Well Key.STEP
OpenStrain Bioreactor Mechanical Unit Solidworks Assembly/Motor screen window.SLDPRT
OpenStrain Bioreactor Mechanical Unit STEP files/Mirrorspur gear_Metric - Spur gear 2M 16T 20PA 5FW ---S16N75H50L5N.STEP
OpenStrain Bioreactor Mechanical Unit STEP files/Linear bearing 6mm.STEP
OpenStrain Bioreactor Mechanical Unit STEP files/BTT S42C Closer Loop Stepper Motor.STEP
OpenStrain Bioreactor Control Unit STEP files/M12.5x1 Panel Nut_default.STEP
OpenStrain Bioreactor Control Unit Solidworks Assembly/M12.5x1 Panel Nut_default.SLDPRT
OpenStrain Bioreactor Mechanical Unit STEP files/hexagon socket head cap screw_as_AS 1420 - M3 x 5-N.STEP
OpenStrain Bioreactor Mechanical Unit STEP files/hexagon socket head cap screw_as_AS 1420 - M3 x 6-N.STEP
OpenStrain Bioreactor Mechanical Unit STEP files/hexagon socket head cap screw_as_AS 1420 - M3 x 8-N.STEP
OpenStrain Bioreactor Mechanical Unit STEP files/hexagon socket head cap screw_as_AS 1420 - M5 x 16-N.STEP
OpenStrain Bioreactor Mechanical Unit STEP files/hexagon socket head cap screw_as_AS 1420 - M5 x 25-N.STEP
OpenStrain Bioreactor Mechanical Unit STEP files/hexagon thin nut (grades a and b) as_AS 1112.4 AB- M3-N.STEP
OpenStrain Bioreactor Mechanical Unit Solidworks Assembly/hexagon socket head cap screw_as.sldprt
OpenStrain Bioreactor Mechanical Unit Solidworks Assembly/hexagon thin nut (grades a and b) as.sldprt
OpenStrain Bioreactor Mechanical Unit Solidworks Assembly/socket head cap screw_am.sldprt
