teameames/OpenStrain-Bioreactor/OpenStrain Bioreactor assembly details.pdf

# OpenStrain Bioreactor parts, assembly, and protocol

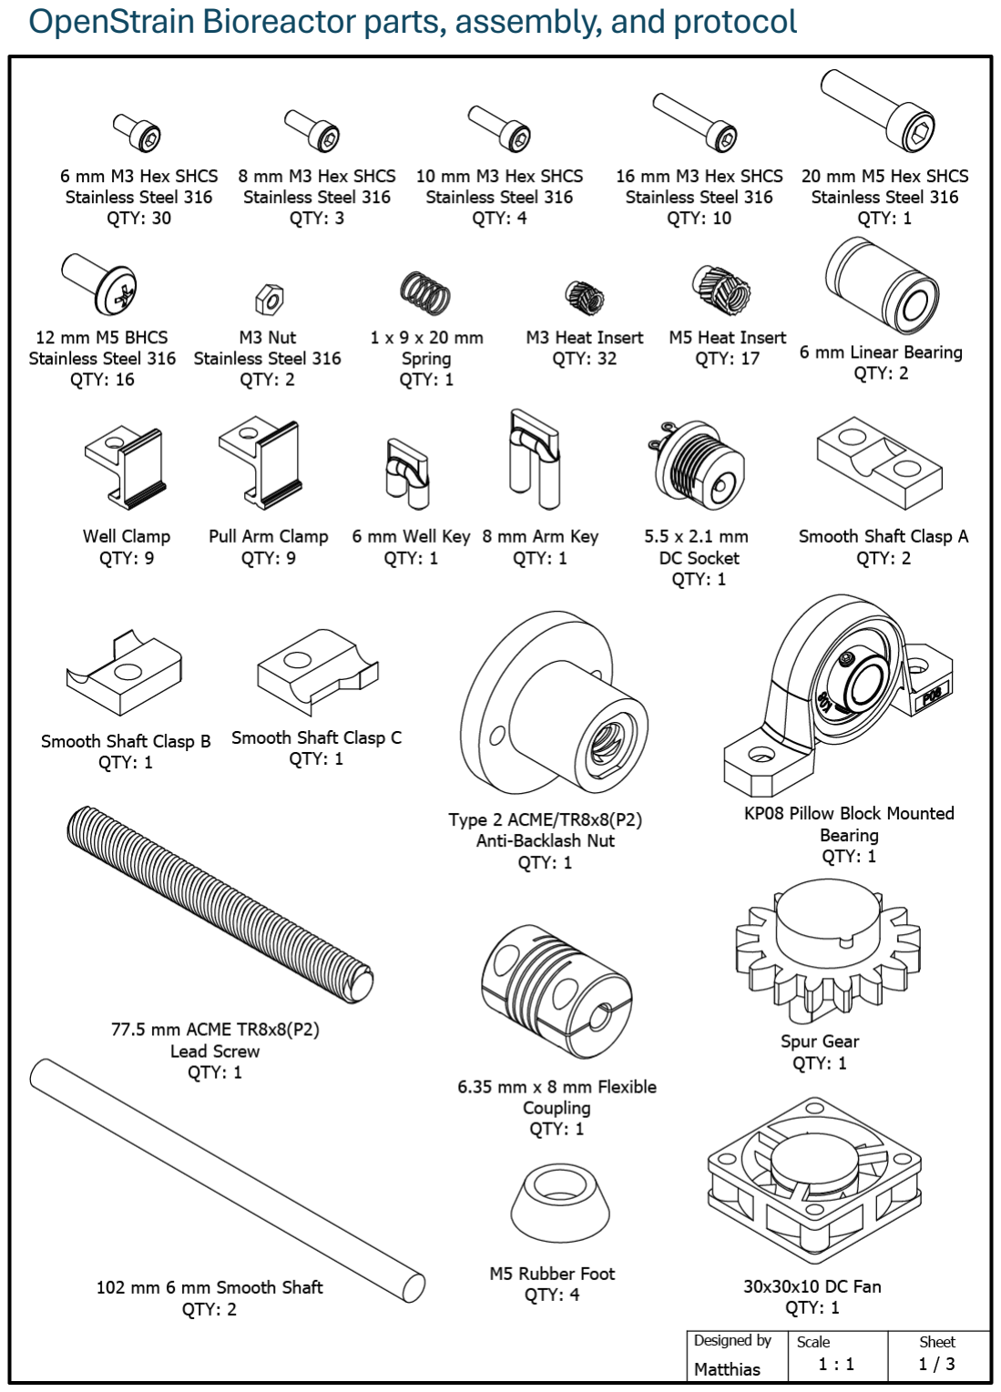
[picture p52: page 1]
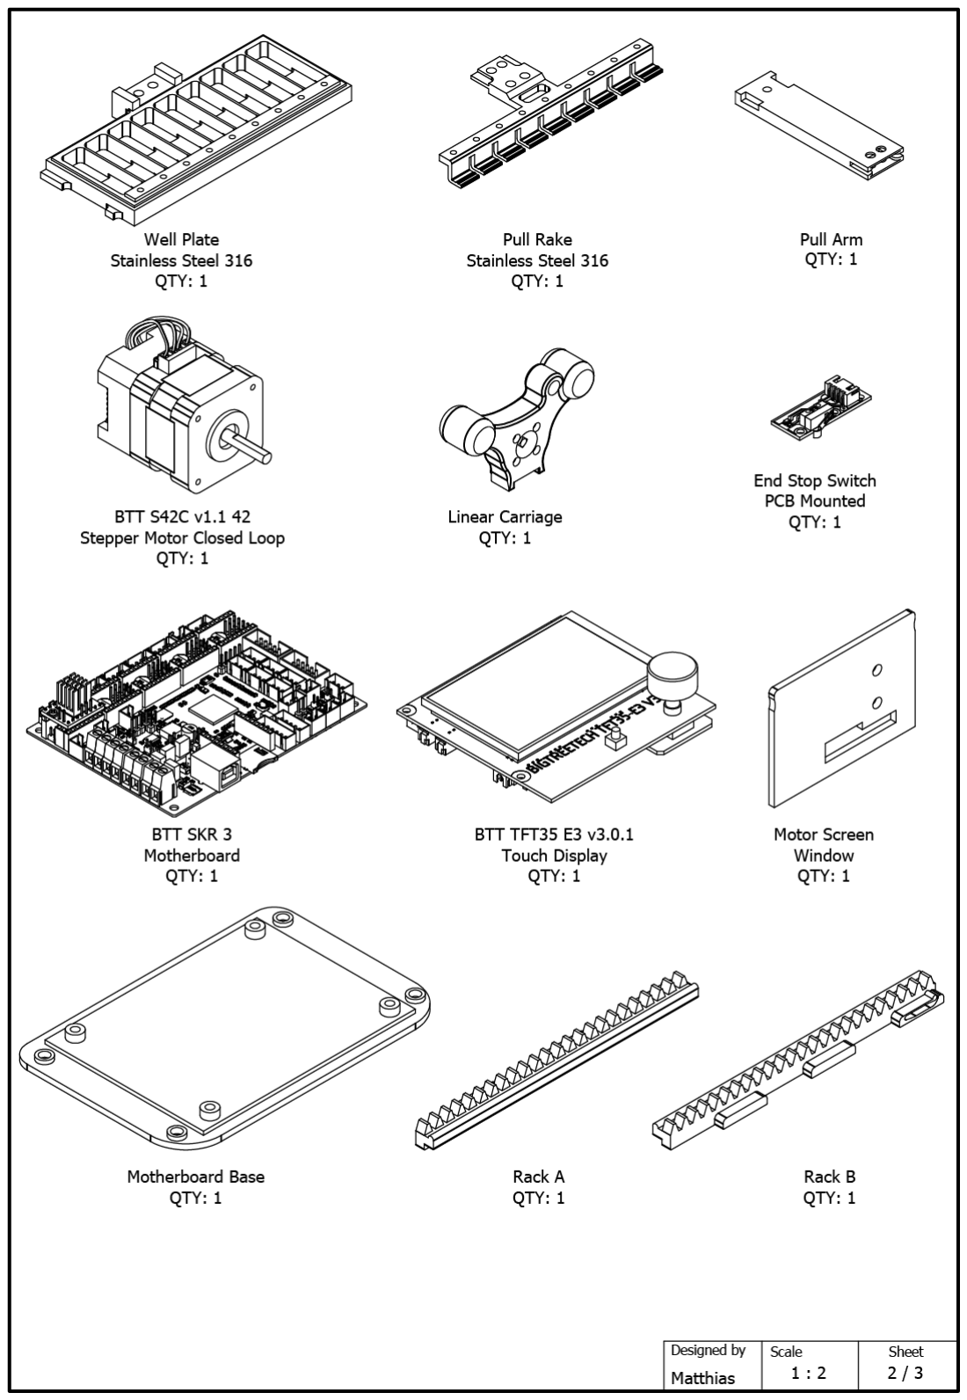
[picture p53: page 2]
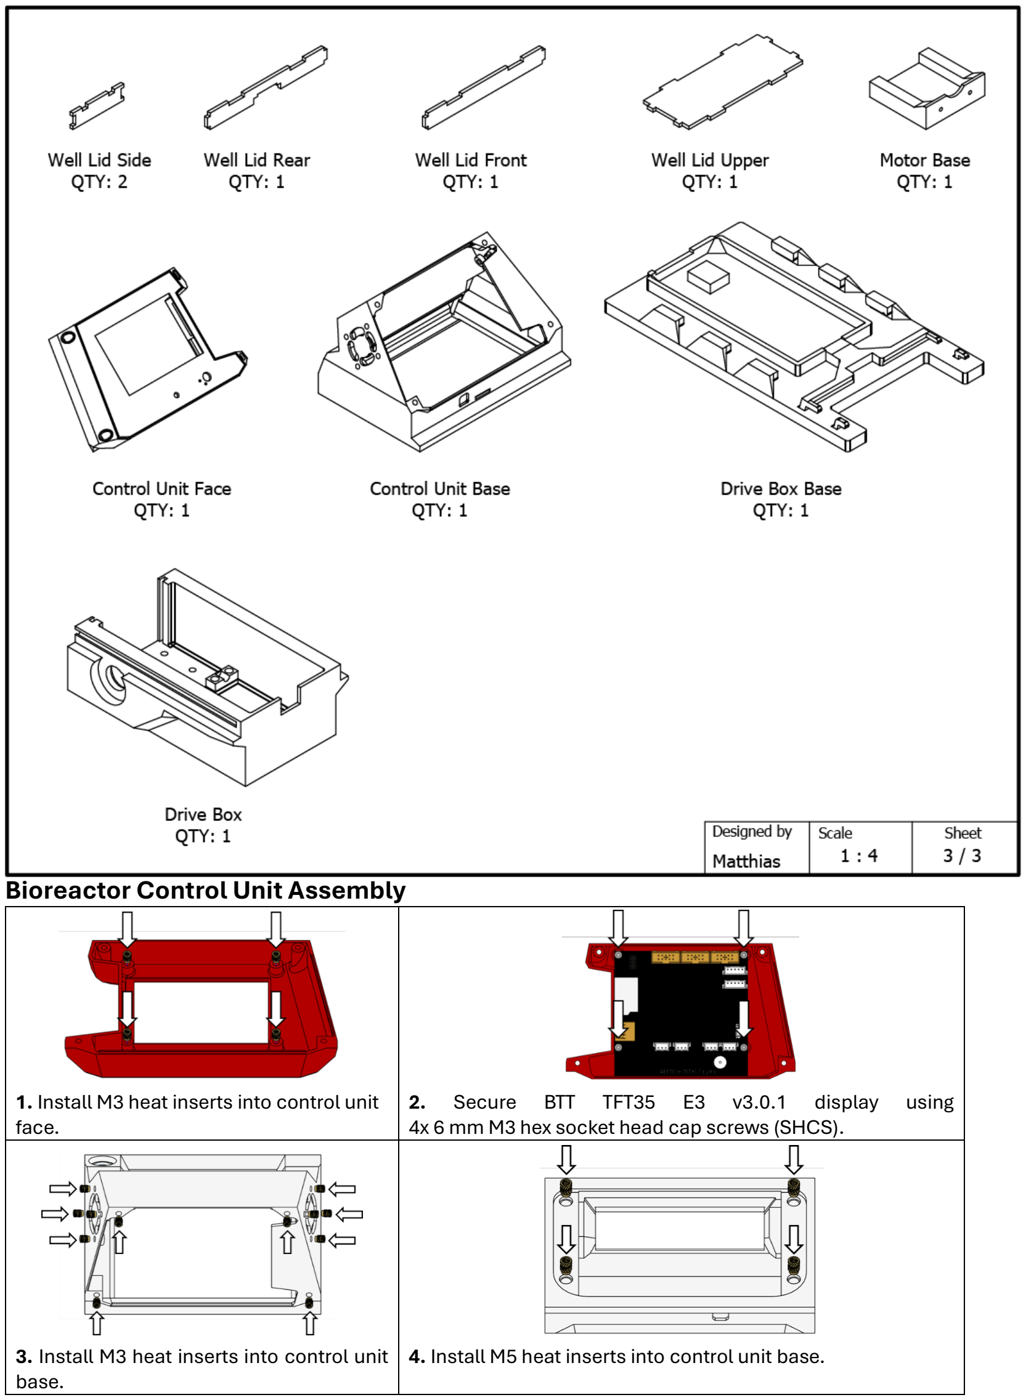
[picture p54: page 3]

### Bioreactor Control Unit Assembly

1. Install M3 heat inserts into control unit face. | 2. Secure BTT TFT35 E3 v3.0.1 display using 4x 6 mm M3 hex socket head cap screws (SHCS).
3. Install M3 heat inserts into control unit base. | 4. Install M5 heat inserts into control unit base.

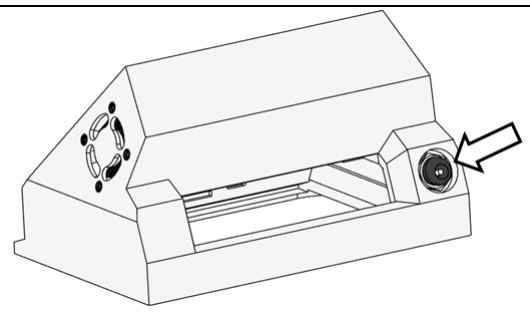
[picture p55: figure]
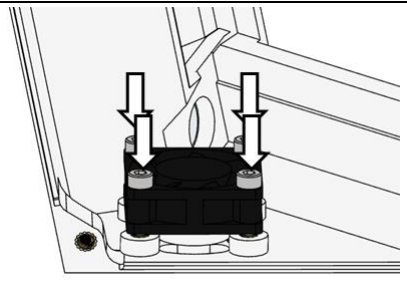
[picture p56: figure]

5. Secure both DC fans using 8x 16mm M3 hex SHCS. Ensure fan orientation vents air outwards. | 6. Solder leads to negative and positive terminals of DC power port. Install DC power port from within casing. Secure with nut on outside of casing.

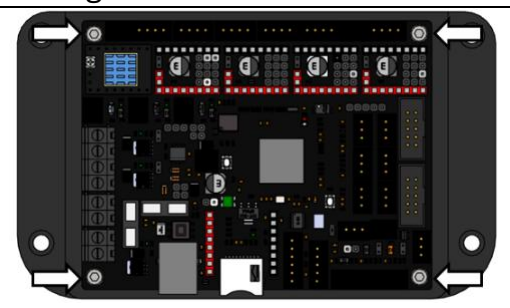
[picture p57: figure]
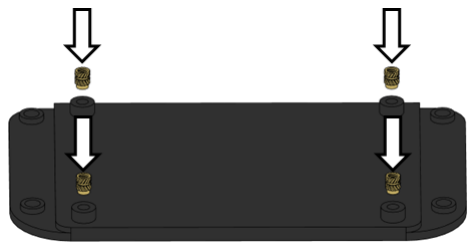
[picture p58: figure]

7. Install M3 heat inserts into motherboard base. | 8. Secure BTT SKR3 motherboard as shown using 4x 6 mm M3 hex SHCS.

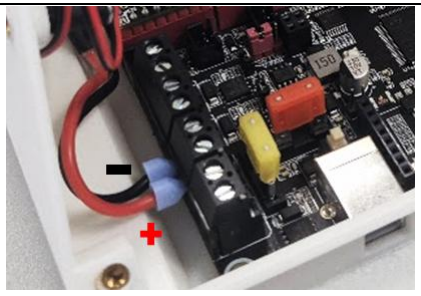
[picture p59: figure]
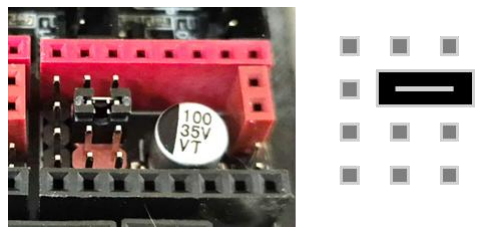
[picture p60: figure]

9. Remove/add jumpers to match above. Version B: | 10. Insert and secure DC power leads to the SKR 3 power input terminals.

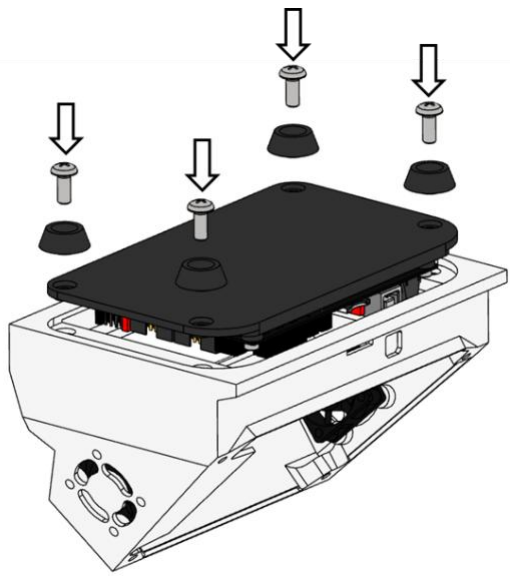
[picture p61: figure]

### 11. Secure motherboard base and

rubber feet to control unit base using 4x 12 mm M5 button head cap screw (BHCS)

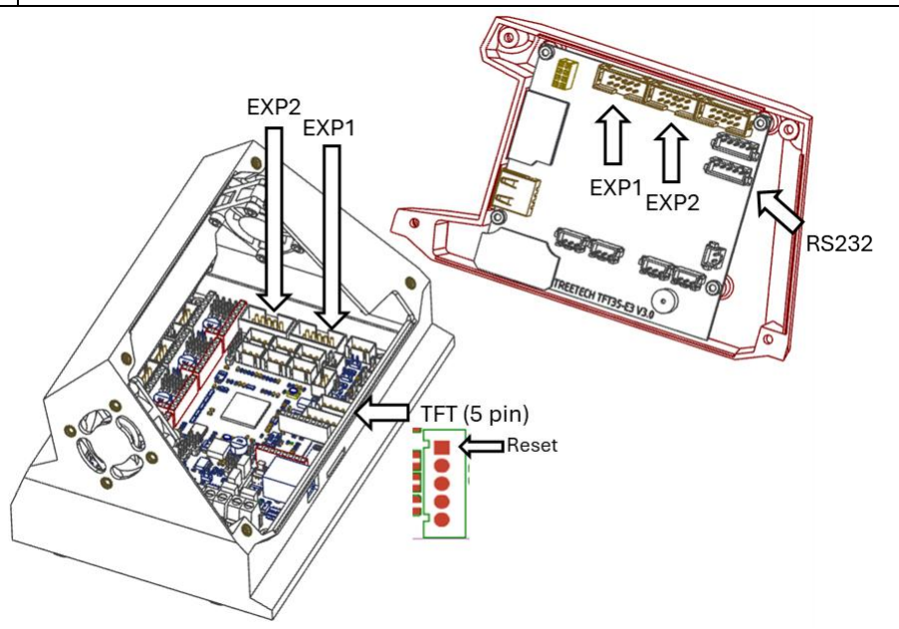
[picture p62: figure]

### 12. Use cables provided with BTT TFT35 display to connect EXP1

to EXP1, EXP2 to EXP2, and TFT to RS232. 5-pin TFT wire can be re-terminated with a 5-pin JST male header to ensure firm connection with motherboard. Ensure reset pin is attached appropriately.

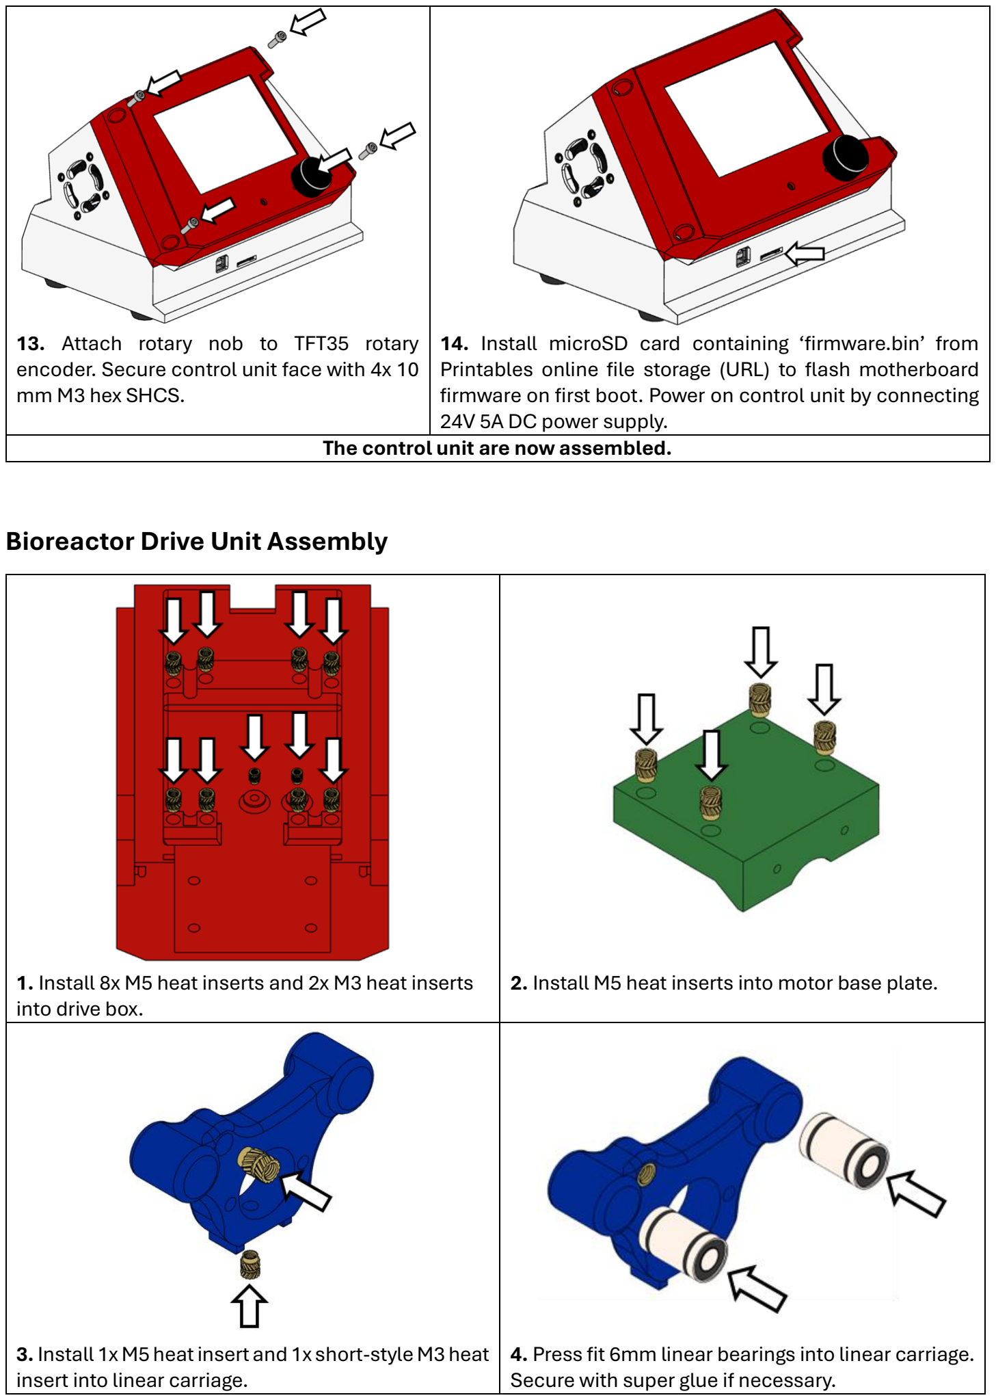
[picture p63: page 5]

### 13. Attach rotary nob to TFT35 rotary

encoder. Secure control unit face with 4x 10 mm M3 hex SHCS.

### 14. Install microSD card containing ‘firmware.bin’ from

Printables online file storage (URL) to flash motherboard firmware on first boot. Power on control unit by connecting 24V 5A DC power supply.
The control unit are now assembled.

### Bioreactor Drive Unit Assembly

1. Install 8x M5 heat inserts and 2x M3 heat inserts into drive box. | 2. Install M5 heat inserts into motor base plate.
3. Install 1x M5 heat insert and 1x short-style M3 heat insert into linear carriage. | 4. Press fit 6mm linear bearings into linear carriage. Secure with super glue if necessary.

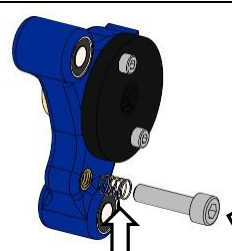
[picture p64: figure]
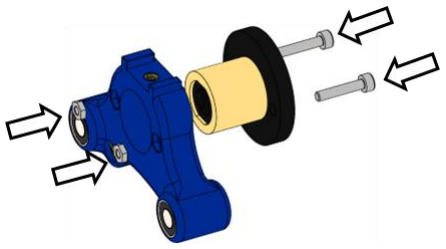
[picture p65: figure]

5. Secure lead nut using 2x M3 nuts and 2x 16 mm hex SHCS. | 6. Install 20 mm M5 hex SHCS with spring into linear carriage such that the spring just starts to compress

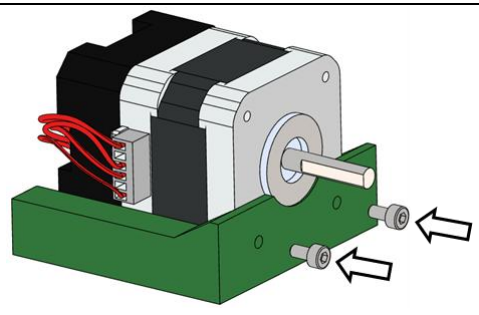
[picture p66: figure]
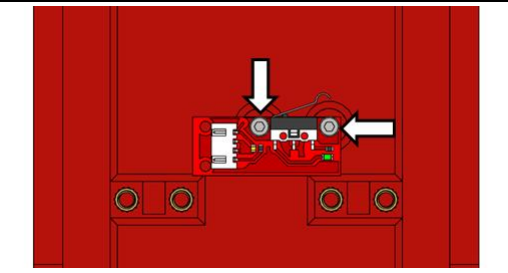
[picture p67: figure]

7. Secure the BTT S42C stepper motor to the motor plate using 2x 6 mm M3 hex SHCS.Match orientation to image above. | 8. Attach the 3-lead limit switch wire to the limit switch. Secure the limit switch to the drive box with 2x 6 mm M3 hex SHCS.

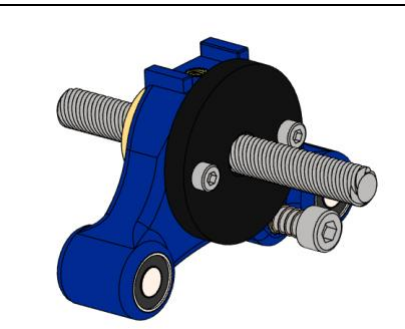
[picture p68: figure]
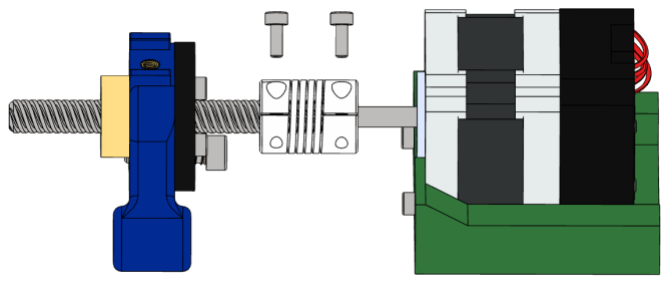
[picture p69: figure]

9. Twist the 8 mm ACME lead screw through the lead nut. Ensure the spring within the lead nut is under tension. | 10. Attach the lead screw to the motor shaft using the flex coupling and 2x 8 mm M3 hex SHCS.

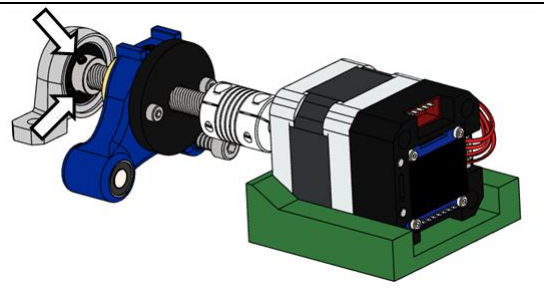
[picture p70: figure]
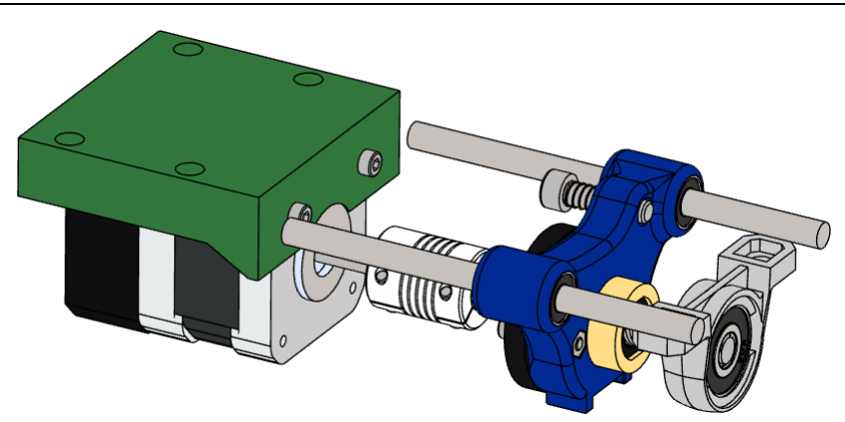
[picture p71: figure]

11. Place the pillow block bearing onto the free end of the lead screw, but do not fasten its internal grub screws yet. | 12. Slide the smooth rods through the linear bearings.

13. Secure the smooth rods and pillow block bearing to the drive box using Smooth Shaft Clasp A (2x), B, & C and with 8x 12 mm M5 BHCS. | 14. Secure the pillow block bearing to the lead screw by fastening its internal grub screws.
15. Secure the motor plate to the drive box using 4x 12 mm M5 BHCS. Slide motor window into the back of the drive box. | 16. Install the spur gears into both sides of the drive box.
17. Slide Rack A & B down rails on drive box. | 18. Install M5 heat inserts into control unit base.
19. Place drive box assembly onto drive plate and secure by turning spur gears. | Limit Switch (3-lead) Motor driver (5-lead) 20.Connect motor to X driver input on motherboard and limit switch to x-lim input on motherboard. Attach extension leads on motherboard side of each cable. Use Y and Z for 2nd and 3rd bioreactors.

Loading the well plate assembly

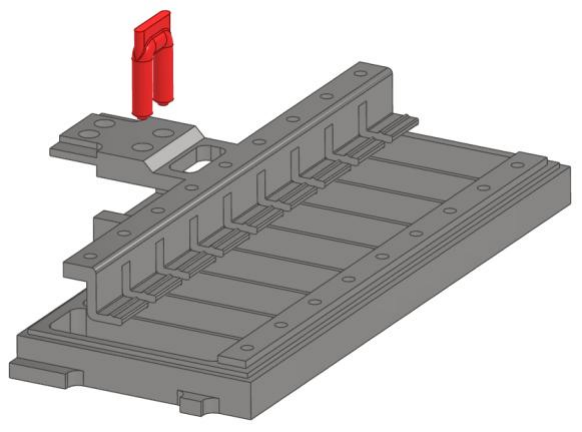
[picture p72: figure]
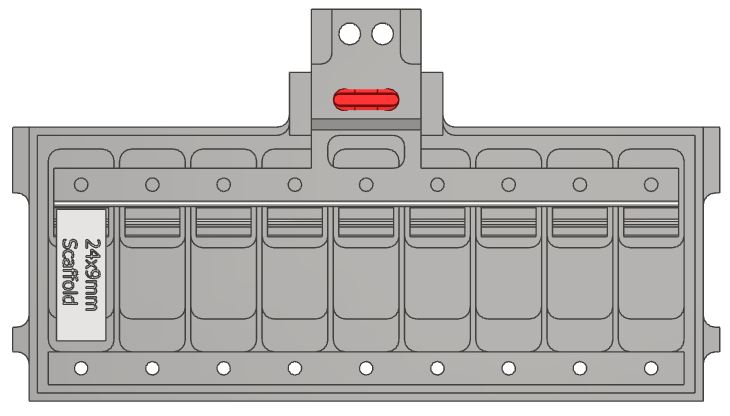
[picture p73: figure]

1. Place pull rake into well plate and secure position with 8 mm well key. | 2. Place scaffold into well.

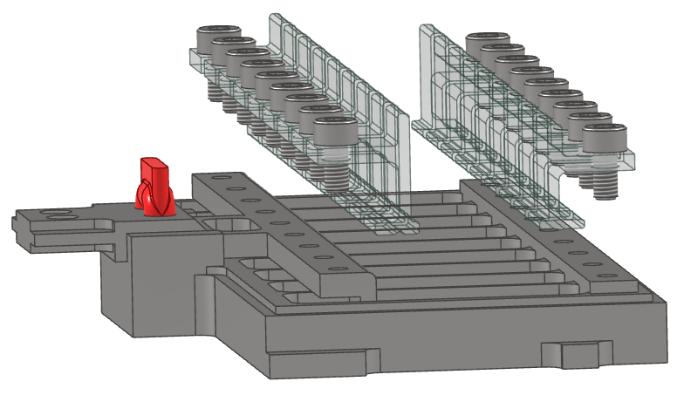
[picture p74: figure]
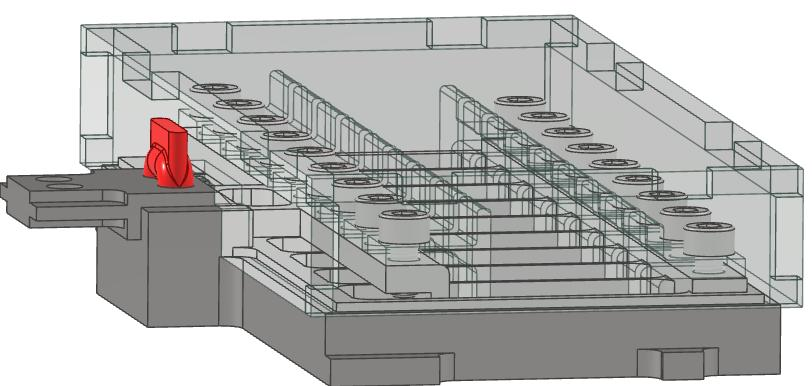
[picture p75: figure]

3. Position 6mm M3 hex SHC screws in pull rake clamps and well clamps, then secure to pull rake and well plate. | 4. Enclose well plate assembly with acrylic well lid.

The drive unit and well plate are now assembled.
