teameames/OpenStrain-Bioreactor/(commit log)

2025-12-11 Add files via upload
    "OpenStrain_GcodeGenerator.m" is a MATLAB script to generate loading regime gcodes to run on the OpenStrain Bioreactor controller.
    "firmware.bin" is a customised Marlin 3D printer firmware used to control the bioreactor units. Install it on the main board of the bioreactor controller
2025-12-15 Add files via upload
    File missing: BigTreeTech SKR 3.
    [30X30X10 DC fan.SLDPRT, Adafruit 5.5 x 2.1 DC Coax Panel Mount Power Jack (PN 601)_default.SLDPRT, Board base.SLDPRT, Case Base V3.SLDPRT, Case Base.SLDPRT, Case Face V3.SLDPRT, Case Face.SLDPRT, Case Master V2.SLDPRT]
2025-12-15 Add files via upload
    Missing BTT SKR 3 part file.
    [30X30X10 DC fan.STEP, Adafruit 5.5 x 2.1 DC Coax Panel Mount Power Jack (PN 601)_default.STEP, Board base.STEP, Case Base V3.STEP, Case Face V3.STEP, Insert M3 D5 L5mm.STEP, Insert M5 D7 L9.5mm.STEP, M12.5x1 Panel Nut_default.STEP]
2025-12-18 Add files via upload
    Parts list and assembly instructions for the OpenStrain Bioreactor system.
